kylehagin/AM3358_Schematic/README.md

# AM3358_Schematic
AM3358 Schematic with ram, lcds, and sd card interface.
