kylehagin/AM3358_Schematic/BOM_DELTA_7_25_2016.xlsx

Sheet: BOM
Description | Designator | Value | Footprint | Manufacturer | Manufacturer Part Number | Quantity | Supplier 1 | Supplier Part Number 1
4.7µF 6.3V Ceramic Capacitor X5R 0402 (1005 Metric) 0.039" L x 0.020" W (1.00mm x 0.50mm) | C1, C2, C6, C7, C100, C121, C139, C152 | 4.7uF, 6.3V | 0402 | Murata Electronics North America | GRM155R60J475ME47D | 8 | Digi-Key | 490-5915-1-ND
25pF 50V Ceramic Capacitor C0G, NP0 0603 (1608 Metric) 0.063" L x 0.031" W (1.60mm x 0.80mm) | C11, C12 | 25pF,50V | 0603 | Samsung Electro-Mechanics America, Inc. | CL10C250JB8NNNC | 2 | Digi-Key | 1276-2244-1-ND
10µF 10V Ceramic Capacitor X5R 0402 (1005 Metric) 0.039" L x 0.020" W (1.00mm x 0.50mm) | C3, C4, C5, C8, C9, C10, C14, C15, C17, C18, C19, C21, C22, C135, C159, C165, C179, C180, C193, C220 | 10uF, 10V | 0402 | Samsung Electro-Mechanics America, Inc. (http://www.digikey.com/en/supplier-centers/s/samsung-electro-mechanics-america) | CL05A106MP8NUB8 | 20 | Digi-Key | 1276-6830-1-ND
18pF 50V Ceramic Capacitor C0G, NP0 0402 (1005 Metric) 0.039" L x 0.020" W (1.00mm x 0.50mm) | C13, C137, C144, C163 | 18pF, 50V | 0402 | Murata Electronics North America | GRM1555C1H180JA01D | 4 | Digi-Key | 490-5858-1-ND
22µF 6.3V Ceramic Capacitor X5R 0402 (1005 Metric) 0.039" L x 0.020" W (1.00mm x 0.50mm) | C16, C116 | 22uF, 6.3V | 0402 | AVX Corporation | 04026D226MAT2A | 2 | Digi-Key | 478-9839-1-ND
2.2µF 6.3V Ceramic Capacitor X5R 0402 (1005 Metric) 0.039" L x 0.020" W (1.00mm x 0.50mm) | C20, C47, C48, C49, C50, C51, C52, C53, C54 | 2.2uF, 6.3V | 0402 | Murata Electronics North America | GRM155R60J225KE95D | 9 | Digi-Key | 490-12532-1-ND
4.7pF 10V Ceramic Capacitor C0G, NP0 0402 (1005 Metric) 0.039" L x 0.020" W (1.00mm x 0.50mm) | C31, C32, C33, C34, C35, C36, C37, C38, C39, C40, C41, C42, C43, C44, C45, C46 | 4.7pF, 10V | 0402 | Wurth Elektronik | 885012005005 | 16 | Digi-Key | 732-7423-1-ND
10000pF 16V Ceramic Capacitor X7R 0402 (1005 Metric) 0.039" L x 0.020" W (1.00mm x 0.50mm) | C23, C24,C25, C26, C27, C28, C29, C102, C103, C104, C105, C106, C107, C108, C109, C110, C111, C112, C113, C114, C115, C117, C118, C134, C149, C154, C157, C167, C170, C171, C172, C173, C174, C175, C176, C177, C178, C181, C182, C183, C184, C185, C186, C187, C188, C192, C194, C195, C196, C197, C198, C199, C200, C201, C202, C203, C204, C205, C206, C207, C208, C209, C210, C211, C212, C213, C214, C215, C216, C217, C218, C219, C221, C222, C223, C224, C225, C226, C227, C228, C229, C230 | 0.01uF, 16V | 0402 | Murata Electronics North America | GRM155R71C103KA01D | 82 | Digi-Key | 490-1313-1-ND
1000pF 50V Ceramic Capacitor X7R 0402 (1005 Metric) 0.039" L x 0.020" W (1.00mm x 0.50mm) | C30, C55 | 0.001uF, 50V | 0402 | Murata Electronics North America | GRM155R71H102KA01D | 2 | Digi-Key | 490-1303-1-ND
0.10µF 16V Ceramic Capacitor X7R 0402 (1005 Metric) 0.039" L x 0.020" W (1.00mm x 0.50mm) | C119, C120, C122, C123, C136, C138, C140, C141, C142, C143, C147, C148, C150, C151, C156, C158, C160, C161, C162, C164, C166, C613 | 0.1uF, 16V | 0402 | Murata Electronics North America | GRM155R71C104KA88J | 22 | Digi-Key | 490-6328-1-ND
0.10µF 6.3V Ceramic Capacitor X7R 0402 (1005 Metric) 0.039" L x 0.020" W (1.00mm x 0.50mm) | C56, C57, C58, C59, C60, C61, C62, C63, C64, C65, C66, C67, C68, C69, C70, C71, C72 | 0.1uF, 6.3V | 0402 | Kemet | C0402C104K9RACTU | 17 | Digi-Key | 399-4872-1-ND
470pF 50V Ceramic Capacitor X7R 0402 (1005 Metric) 0.039" L x 0.020" W (1.00mm x 0.50mm) | C124 | 470pF, 5%, 50V | 0402 | Murata Electronics North America | GRM155R71H471JA01D | 1 | Digi-Key | 490-6362-1-ND
1µF 10V Ceramic Capacitor X5R 0402 (1005 Metric) 0.039" L x 0.020" W (1.00mm x 0.50mm) | C125, C189, C190, C191, C231, | 1uF, 10V | 0402 | Murata Electronics North America | GRM155R61A105KE15D | 5 | Digi-Key | 490-3890-1-ND
0.022µF 10V Ceramic Capacitor X7R 0402 (1005 Metric) 0.039" L x 0.020" W (1.00mm x 0.50mm) | C130 | 0.022uF, 10V | 0402 | Taiyo Yuden | LMK105B7223KV-F | 1 | Digi-Key | 587-2476-1-ND
30pF 50V Ceramic Capacitor C0G, NP0 0402 (1005 Metric) 0.039" L x 0.020" W (1.00mm x 0.50mm) | C131, C132 | 30pF, 50V | 0402 | Murata Electronics North America | GRM1555C1H300JA01D | 2 | Digi-Key | 490-5935-1-ND
100µF 6.3V Aluminum Capacitors Radial, Can - SMD 2000 Hrs @ 85°C | C133 | 100uF, 6.3V | Radial, SMD Series S Type V | Panasonic Electronic Components | EEE-0JA101WR | 1 | Digi-Key | PCE3853CT-ND
27pF 50V Ceramic Capacitor C0G, NP0 0402 (1005 Metric) 0.039" L x 0.020" W (1.00mm x 0.50mm) | C153, C155 | 27pF, 50V | 0805 | Samsung Electro-Mechanics America, Inc. | CL05C270JB5NNNC | 2 | Digi-Key | 1276-1153-1-ND
LED GREEN CLEAR 0805 SMD | D1 |  |  | Dialight | 5988170107F | 1 | Digi-Key | 350-2044-1-ND
Low Current LED | D2, D3, D4, D5 | InGaAlP LED | PLCC-2 package | TOPLED | LG T67K-H2K1-24-Z | 4 | Digi-Key | 475-2679-1-ND
ESD protection for ultra high-speed interfaces | D6, D7 | TVS ARRAY | DFN2510A-10 (SOT1176-1) | NXP | IP4283CZ10-TBR | 2 | Digi-Key | 568-10487-1-ND
Schottky barrier single diodes | D8 | Schottky diodes | SOD323 (SC-76) | NXP | RB751V40,115 | 1 | Digi-Key | 568-8119-1-ND
FIXED IND 1.5NH 800MA 150 MOHM | FB1, FB4, FB5, FB6, FB7, FB8, FB9 , FB10 | 150OHM 800mA | 0603 | Toko America Inc. | PTL1608-F1N5C | 8 | Digi-Key | TKS2902CT-ND
FIXED IND 2.2UH 2.6A 115 MOHM | L1, L2, L3, L4 | 2.2uH,2.6A | 1008 (2520 Metric) | Murata Electronics North America | DFE252010P-2R2M=P2 | 4 | Digi-Key | 490-10637-1-ND
HDMI Type D Receptacle | P1 |  |  | FCI | 10118242-001RLF | 1 | Digikey | 609-4617-1-ND
USB - mini A Receptacle Connector 5 Position Surface Mount | P2 | USB - mini A |  | TE Connectivity | 1734327-1 | 1 | Digikey | A123107-ND
USB - mini A Receptacle Connector 5 Position Surface Mount | P3 | USB - mini B |  | HIROSE | UX60-MB-5ST | 1 | Digikey | H2959CT-ND
Micro SD Card Socket | P4 | microSD |  | Molex | 0492250821 | 1 | Digikey | WM3295CT-ND
DC POWER JACK - RIGHT ANGLED - THT - 2.0 & 2.5Ø -WR-DC | P5 | DC POWER JACK | THT - 2.0 & 2.5Ø -WR-DC | Wurth Elektronik | 694106301002 | 1 | Digikey | 732-5930-ND
.100” [2.54 mm] Contact Centers, Female Headers | P6 | 2x5 Female Headers | .100” [2.54 mm] | Sullins | PPTC052LFBN-RC | 1 | Digikey | S6105-ND
10 Position Receptacle Connector 0.079" (2.00mm) Surface Mount Gold | P7 | 10 Position Receptacle Connector | 0.079" (2.00mm) Surface Mount | Molex | 0791091004 | 1 | Digikey | WM18700-ND
.100” [2.54 mm] Contact Centers, Female Headers | P8, P9 | 2 x23 Female Headers | .100” [2.54 mm] | Sullins | PPPC232LFBN-RC | 2 | Digikey | S7126-ND
WE-RJ45-LAN-10/100BT | P10 | ;'RJ45-LAN-10/100BT |  | Wurth Elektronik | 7499010211A | 1 | Digikey | 732-4506-5-ND
Sitara™ ARM® Cortex®-A8 32‑Bit RISC Processor | IC1 |  | NFBGA (324) | Texas Instrument | AM3358BZCZ100 | 1 | Digikey | 296-35869-5-ND
250-mA LDO REGULATORS | IC2 |  | 8-VSSOP | Texas Instrument | TPS77301DGK | 1 | Digikey | 296-8108-5-ND
Positive Overvoltage Protection Controller with Internal Low RON NMOS FET | U1 |  | DFN6 | ON Semiconductor | NCP349MNBKTBG | 1 | Digikey | NCP349MNBKTBGOSCT-ND
Single-Chip PMIC for Battery-Powered Systems | U2 | 2-A Output Current | VQFN (48) | Texas Instrument | TPS65217BRSLR | 1 | Digikey | 296-40879-1-ND
1K Microwire Compatible Serial EEPROM | U3 | 1Kbit | SOT-23-6 | Microchip | 93C46BT-I/OT | 1 | Digikey | 93C46BT-IOTCT-ND
Low power, 150 MHz pixel rate HDMI 1.4a transmitter with 3 x 8-bit video inputs, HDCP and CEC support | U5 | 150 MHz pixel rate | SOT804-4 | NXP | TDA19988BHN C1,557 | 1 | Digikey | 568-12059-ND
DDR2 SDRAM | U6 | 16 Meg x 16 x 8 banks | 90-FBGA | Micron | MT47H128M16RT-25EC | 1 | Digikey | 557-1535-ND
256 kb I2C CMOS Serial EEPROM | U7 | 256 kb | SOIC8 | ON Semiconductor | CAT24C256WI-GT3 | 1 | Digikey | CAT24C256WI-GT3OSCT-ND
4Gb DDR3L, IC SDRAM DDR3 256M X 16 | U8 | 4Gb | 96-FBGA | Alliance Memory | AS4C256M16D3L-12BCN | 1 | Digikey | 1450-1097-ND
IC 0.5A Power-Distribution Switches | U9 | 500-Ma | DGN | Texas Instrument | TPS2051BDGNR | 1 | Digikey | 296-17313-1-ND
4-Channel ESD Solution for USB-HS/USB OTG/USB Charger Interface | U10 |  | DRY(R-PUSON-N6) | Texas Instrument | TPD4S012DRYR | 1 | Digikey | 296-24244-1-ND
2-Port USB 2.0 Hi-Speed Hub Controller | U11 |  | QFN28 | SMSC | USB2412-DZK-TR | 1 | Digikey | USB2412-DZK-CT-ND
Dual High Speed USB to Multipurpose UART/FIFO IC | U12 |  | QFN64-HQ | FTDI | FT2232HQ-REEL | 1 | Digikey | 768-1025-1-ND
Small Footprint MII/RMII 10/100 Ethernet Transceiver with HP Auto-MDIX and flexPWR® Technology | U13 | 10/100 Ethernet Transceiver | 32-QFN | SMSC | LAN8710A-EZC-TR | 1 | Digikey | LAN8710A-EZC-CT-ND
Dual 2-Input Positive-NAND Gate | U14 | NAND Gate | DCK(R-PDSO-G6) | Texas Instrument | SN74LVC2G00DCUR | 1 | Digikey | 296-13258-1-ND
Small Footprint MII/RMII 10/100 Ethernet Transceiver with HP Auto-MDIX and flexPWR® Technology | U15 | 10/100 Ethernet Transceiver | 32-QFN | SMSC | LAN8710A-EZC-TR | 1 | Digikey | LAN8710A-EZC-CT-ND
SN74LVC2G07 Dual Buffer and Driver With Open-Drain Outputs | U16 | 24-mA Output Drive at 3.3 V | DCK(R-PDSO-G6) | Texas Instrument | SN74LVC2G07DCKR | 1 | Digikey | 296-13495-1-ND
Silicon NPN epitaxial planar type | Q1, Q2 | Silicon NPN | SOT-363 | Panasonic | DMC564040R | 1 | Digikey | DMC564040RCT-ND
TRANS NPN PREBIAS/PNP SSMINI6 | Q3 | 1 NPN Pre-Biased, 1 PNP | SOT-364 | Panasonic | DME914C10R | 1 | Digikey | DME914C10RCT-ND
RES SMD 4.75K OHM 1% 1/16W 0402 | R1, R152, R162, R176, R179 | 4.75K, 1% | 0402 | Yageo | RC0402FR-074K75L | 5 | Digikey | 311-4.75KLCT-ND
RES SMD 12.1K OHM 1% 1/16W 0402 | R2, R145, R157, R167, R282 | 12.1K, 1% | 0402 | Yageo | RC0402FR-0712K1L | 5 | Digikey | 311-12.1KLRCT-ND
RES SMD 0.1 OHM 1% 1/10W 0402 | R3, R138 | 0.1 | 0402 | Samsung Electro-Mechanics America, Inc. | RUT1005FR100CS | 2 | Digikey | 1276-6167-1-ND
RES SMD 1.5K OHM 5% 1/16W 0402 | R4, R7, R20, R21, R30, R131 | 1.5K, 5% | 0402 | Yageo | RC0402JR-071K5L | 3 | Digikey | 311-1.5KJRCT-ND
RES SMD 470 OHM 5% 1/16W 0402 | R6, R16, R96, R97, R98, R99 | 470, 5% | 0402 | Yageo | RC0402JR-07470RL | 6 | Digikey | 311-470JRCT-ND
RES SMD 100K OHM 1% 1/16W 0402 | R8, R9, R81, R82, R84, R94, R116, R117, R118, R119, R132, R151, R156, R159, | 100K, 1% | 0402 | Yageo | RC0402FR-07100KL | 14 | Digikey | 311-100KLRCT-ND
RES SMD 100 OHM 1% 1/16W 0402 | R135, R136, R137, R139, R153, R205, R206, R207, R208, R279 | 100, 1% | 0402 | Yageo | RC0402FR-07100RL | 10 | Digikey | 311-100LRCT-ND
RES SMD 0.0OHM JUMPER 1/16W 0402 | R11, R12, R13, R14, R15, R19, R28, R78, R120, R121, R142, R146, R161, R163, R164, R165, R166, R168, R169, R170, R171, R172, R197, R199, R202, R204, R217, R222, R224, R275, R277, R278 | 0 | 0402 | Yageo | RC0402JR-070RL | 32 | Digikey | 311-0.0JRCT-ND
RES SMD 42.2K OHM 1% 1/16W 0402 | R103, R105, R106, R107, R108, R109, R110, R111, R112, R113, R115 | 42.2K, 1% | 0402 | Yageo | RC0402FR-0742K2L | 11 | Digikey | 311-42.2KLRCT-ND
RES SMD 10K OHM 1% 1/16W 0402 | R18, R24, R26, R27, R29, R31, R32, R33, R34, R123, R124, R125, R147, R148, R174, R187, R190, R191, R192, R193, R194, R195, R196, R210, R212, R214, R216, R219, R220, R276, R283 | 10K, 1% | 0402 | Yageo | RC0402FR-0710KL | 26 | Digikey | 311-10.0KLRCT-ND
RES SMD 10 OHM 1% 1/16W 0402 | R144 | 10, 1% | 0402 | Yageo | RC0402FR-0710RL | 1 | Digikey | 311-10.0LRCT-ND
RES SMD 49.9 OHM 1% 1/16W 0402 | R129, R130, R133, R134, R229 | 49.9, 1% | 0402 | Yageo | RC0402FR-0749R9L | 5 | Digikey | 311-49.9LRCT-ND
RES SMD 52.3K OHM 1% 1/16W 0402 | R150 | 52.3K, 1% | 0402 | Yageo | RC0402FR-0752K3L | 1 | Digikey | YAG3179CT-ND
RES SMD 2.2K OHM 1% 1/16W 0402 | R175, R188, R226, R232 | 2.2K, 1% | 0402 | Yageo | RC0402FR-072K2L | 4 | Digikey | 311-2.20KLRCT-ND
RES SMD 30.1K OHM 1% 1/16W 0402 | R189 | 30.1K, 1% | 0402 | Yageo | RC0402FR-0730K1L | 1 | Digikey | 311-30.1KLRCT-ND
RES SMD 33 OHM 5% 1/16W 0402 | R201, R225, R227, R228, R229, R230, R231, R232, R233, R234, R235, R236, R237, R238, R239, R240, R241, R242, R243, R244, R245, R246, R247, R248, R249, R250, R251, R252, R253, R254, R255, R256, R257, R258, R259,R260, R261, R262, R263, R264, R265, R266, R267, R268, R269, R270, R271, R272, R273, R274 | 33 | 0402 | Yageo | RC0402JR-0733RL | 50 | Digikey | 311-33JRCT-ND
RES SMD 1M OHM 1% 1/16W 0402 | R223 | 1M, 1% | 0402 | Yageo | RC0402FR-071ML | 1 | Digikey | 311-1.00MLRCT-ND
RES SMD 27K OHM 1% 1/10W 0402 | R23, R27 | 27K, 1% | 0402 | Panasonic Electronic Components | ERJ-2RKF2702X | 2 | Digikey | P27.0KLCT-ND
RES SMD 240 OHM 1% 1/16W 0402 | R25 | 240 | 0402 | Yageo | C0402FR-07240RL | 1 | Digikey | 311-240LRCT-ND
RES SMD 7.5 OHM 1% 1/16W 0402 | R35 | 7.5 OHM | 0402 | Samsung Electro-Mechanics America, Inc. | RC1005F7R5CS | 1 | Digikey | 1276-3880-1-ND
Overcurrent Protection Device | RT1 | 60V MAX, 40A MAX | Through hole | TE Connectivity | RXEF010 | 1 | Digikey | RXEF010HF-ND
Ultra-small Tactile Switch (SMT) | S1 | SPST-NO | (1.2 × 3 × 2.5 mm (H × W × D) | Omron | B3U-1100P | 1 | Digikey | SW1021CT-ND
ATS/ATS-SM Series Quartz Crystal | Y4 | 25MHz | HC-49/US-SM [surface mount] | CTS Electronic Components | ATS250B-E | 1 | Digikey | CTX928-ND
12MHz ±50ppm Crystal 8pF 80 Ohm -10°C ~ 70°C Surface Mount 2-SMD, No Lead (DFN, LCC) | Y6 | 12MHz | 2-SMD, No Lead (DFN, LCC) | NDK | NX8045GB-12.000000MHZ | 1 | Digikey | 644-1020-1-ND
kHz RANGE CRYSTAL UNIT | Y7 | 32.768 kHz | 8.0 × 3.8 × 2.54 mm | Seiko Epson Corp | MC-306 32.7680K-A0 | 1 | Digikey | SER2407CT-ND
Surface Mount Quartz Crystal | Y8, Y5 | 24MHz | 5.0mm x 3.2mm | CTS Electronic Components | 405I35D24M00000 | 1 | Digikey | CTX1198CT-ND

Sheet: Sheet1
0.21653999 | -0.60803002
4.15353999 | -0.60803002
0.39525997 | -2.26156004
3.97525997 | -2.26156004
 | 0.06299003
 | 0.05512008
