kylehagin/AM3358_Schematic/DELTA_7_25_2016.brd

## EAGLE design DELTA_7_25_2016.brd (2018-07-20)

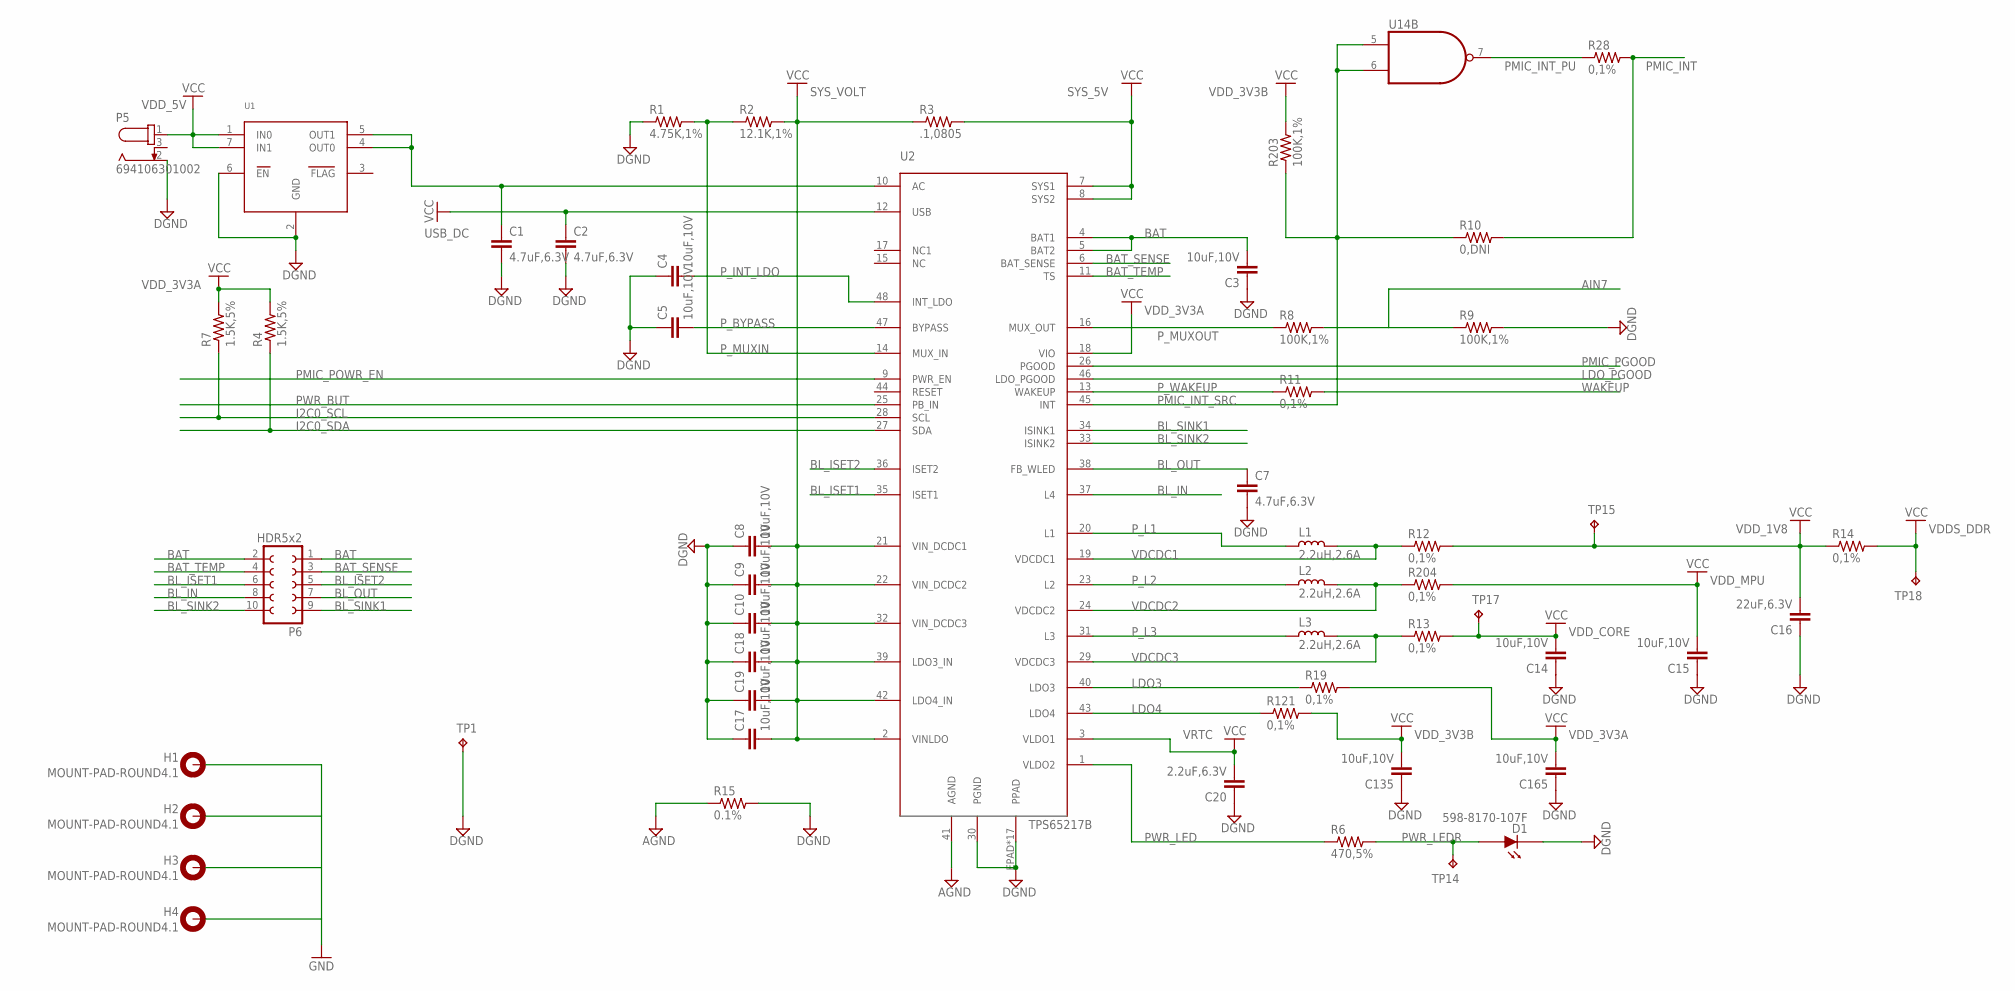
[picture p1: schematic DELTA_7_25_2016.sch, sheet 1]

Parts:
C1, C2, C7: 4.7uF,6.3V; C0402
C3, C4, C5, C8, C9, C10, C14, C15, C17, C18, C19, C135, C165: 10uF,10V; C0402
C16: 22uF,6.3V; C0402
C20: 2.2uF,6.3V; C0402
D1: 598-8170-107F; 0805P
H1, H2, H3, H4: MOUNT-PAD-ROUND4.1; 4,1-PAD
L1, L2, L3: 2.2uH,2.6A; L1008
P5: 694106301002
P6: HDR5x2; FE05-2
R1: 4.75K,1%; R0402
R2: 12.1K,1%; R0402
R3: .1,0805; R0402
R4, R7: 1.5K,5%; R0402
R6: 470,5%; R0402
R8, R9, R203: 100K,1%; R0402
R10: 0,DNI; R0402
R11, R12, R13, R14, R19, R28, R121, R204: 0,1%; R0402
R15: 0.1%; R0402
TP1, TP14, TP15, TP17, TP18: TPB1,27; B1,27
U1: NCP349; DFN6
U2: TPS65217B; RSL(S-PVQFN-N48)
U14: SN74LVC2G00DCU; DCU(S-PDSO-G8)

Connections:
AGND: R15.1, U2.41 (AGND)
AIN7: R8.2, R9.1; also elsewhere on the board
BAT: C3.2, P6.1, P6.2, U2.4 (BAT1), U2.5 (BAT2)
BAT_SENSE: P6.3, U2.6 (BAT_SENSE)
BAT_TEMP: P6.4, U2.11 (TS)
BL_IN: P6.8, U2.37 (L4)
BL_ISET1: P6.6, U2.35 (ISET1)
BL_ISET2: P6.5, U2.36 (ISET2)
BL_OUT: C7.1, P6.7, U2.38 (FB_WLED)
BL_SINK1: P6.9, U2.34 (ISINK1)
BL_SINK2: P6.10, U2.33 (ISINK2)
DGND: C1.2, C2.2, C3.1, C4.1, C5.1, C7.2, C8.1, C9.1, C10.1, C14.1, C15.1, C16.1, C17.1, C18.1, C19.1, C20.1, C135.1, C165.1, D1.2 (D_OUT), P5.2, R1.1, R9.2, R15.2, TP1.TP, U1.2 (GND), U1.6 (EN), U2.30 (PGND), U2.EPAD (PPAD), U2.P$1 (PPAD), U2.P$2 (PPAD), U2.P$3 (PPAD), U2.P$4 (PPAD), U2.P$5 (PPAD), U2.P$6 (PPAD), U2.P$7 (PPAD), U2.P$8 (PPAD), U2.P$9 (PPAD), U2.P$10 (PPAD), U2.P$11 (PPAD), U2.P$12 (PPAD), U2.P$13 (PPAD), U2.P$14 (PPAD), U2.P$15 (PPAD), U2.P$16 (PPAD); also elsewhere on the board
GND: H1.B4,1, H2.B4,1, H3.B4,1, H4.B4,1; also elsewhere on the board
I2C0_SCL: R7.1, U2.28 (SCL); also elsewhere on the board
I2C0_SDA: R4.1, U2.27 (SDA); also elsewhere on the board
LDO3: R19.1, U2.40 (LDO3)
LDO4: R121.1, U2.43 (LDO4)
LDO_PGOOD: U2.46 (LDO_PGOOD); also elsewhere on the board
unnamed: C1.1, U1.4 (OUT0), U1.5 (OUT1), U2.10 (AC)
PMIC_INT: R10.2, R28.2; also elsewhere on the board
PMIC_INT_PU: R28.1, U14.7 (O)
PMIC_INT_SRC: R10.1, R203.1, U2.45 (INT), U14.5 (I0), U14.6 (I1)
PMIC_PGOOD: U2.26 (PGOOD); also elsewhere on the board
PMIC_POWR_EN: U2.9 (PWR_EN); also elsewhere on the board
PWR_BUT: U2.25 (PB_IN); also elsewhere on the board
PWR_LED: R6.1, U2.1 (VLDO2)
PWR_LEDR: D1.1 (D_IN), R6.2, TP14.TP
P_BYPASS: C5.2, U2.47 (BYPASS)
P_INT_LDO: C4.2, U2.48 (INT_LDO)
P_L1: L1.2, U2.20 (L1)
P_L2: L2.2, U2.23 (L2)
P_L3: L3.2, U2.31 (L3)
P_MUXIN: R1.2, R2.1, U2.14 (MUX_IN)
P_MUXOUT: R8.1, U2.16 (MUX_OUT)
P_WAKEUP: R11.1, U2.13 (WAKEUP)
SYS_5V: R3.2, U2.7 (SYS1), U2.8 (SYS2); also elsewhere on the board
SYS_VOLT: C8.2, C9.2, C10.2, C17.2, C18.2, C19.2, R2.2, R3.1, U2.2 (VINLDO), U2.21 (VIN_DCDC1), U2.22 (VIN_DCDC2), U2.32 (VIN_DCDC3), U2.39 (LDO3_IN), U2.42 (LDO4_IN); also elsewhere on the board
USB_DC: C2.1, U2.12 (USB); also elsewhere on the board
VDCDC1: L1.1, R12.1, U2.19 (VDCDC1)
VDCDC2: L2.1, R204.1, U2.24 (VDCDC2)
VDCDC3: L3.1, R13.1, U2.29 (VDCDC3)
VDDS_DDR: R14.2, TP18.TP; also elsewhere on the board
VDD_1V8: C16.2, R12.2, R14.1, TP15.TP; also elsewhere on the board
VDD_3V3A: C165.2, R4.2, R7.2, R19.2, U2.18 (VIO); also elsewhere on the board
VDD_3V3B: C135.2, R121.2, R203.2; also elsewhere on the board
VDD_5V: P5.1, U1.1 (IN0), U1.7 (IN1); also elsewhere on the board
VDD_CORE: C14.2, R13.2, TP17.TP; also elsewhere on the board
VDD_MPU: C15.2, R204.2; also elsewhere on the board
VRTC: C20.2, U2.3 (VLDO1); also elsewhere on the board
WAKEUP: R11.2; also elsewhere on the board

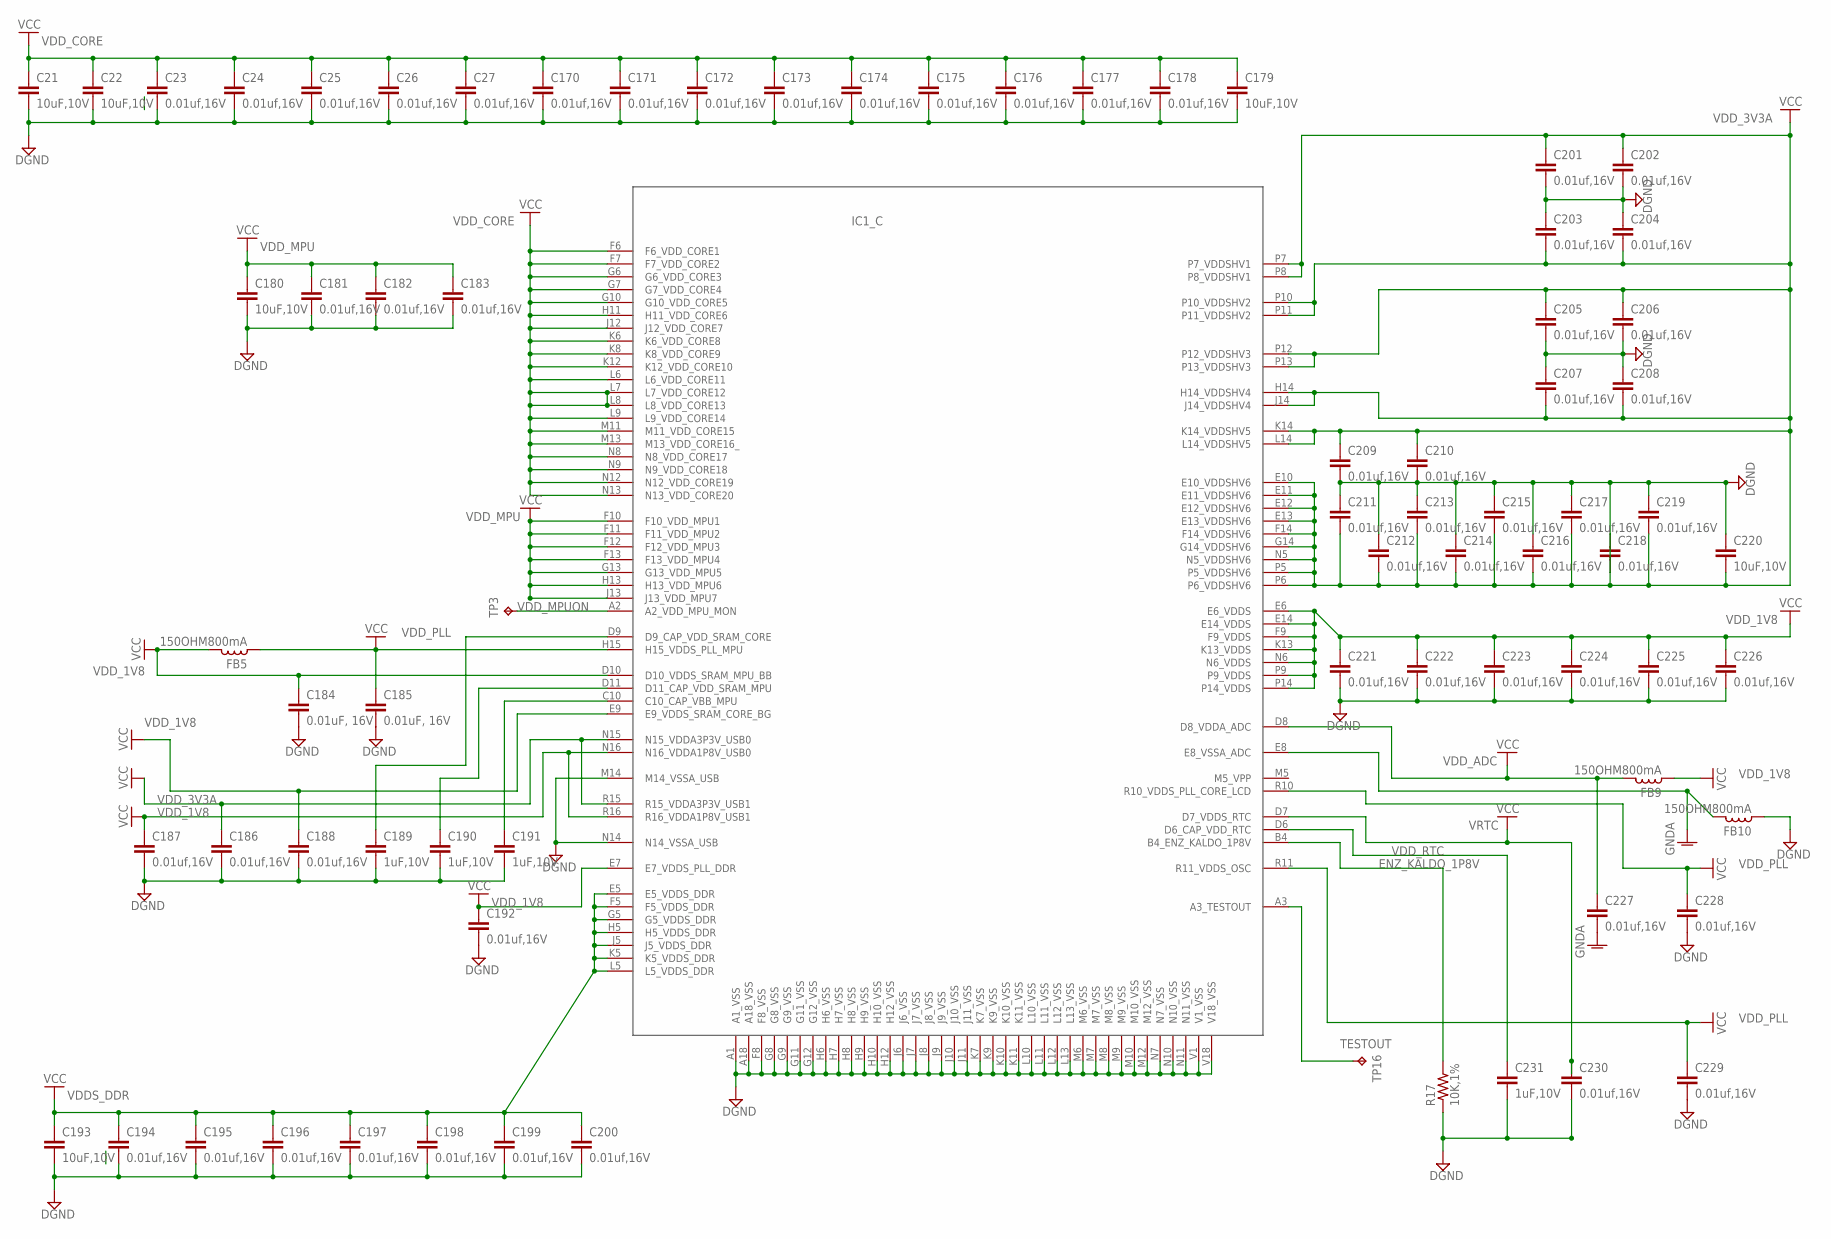
[picture p2: schematic DELTA_7_25_2016.sch, sheet 2]

Parts:
C21, C22, C179, C180, C193, C220: 10uF,10V; C0402
C23, C24, C25, C26, C27, C170, C171, C172, C173, C174, C175, C176, C177, C178, C181, C182, C183, C186, C187, C188, C192, C194, C195, C196, C197, C198, C199, C200, C201, C202, C203, C204, C205, C206, C207, C208, C209, C210, C211, C212, C213, C214, C215, C216, C217, C218, C219, C221, C222, C223, C224, C225, C226, C227, C228, C229, C230: 0.01uf,16V; C0402
C184, C185: 0.01uF, 16V; C0402
C189, C190, C191, C231: 1uF,10V; C0402
FB5, FB9: 150OHM800mA; L0603
FB10: 150OHM800mA; L1812
IC1: AM335X_ZCZ; ZCZ_S-PBGA-N324
R17: 10K,1%; R0402
TP3, TP16: TPB1,27; B1,27

Connections:
DGND: C21.2, C22.2, C23.2, C24.2, C25.2, C26.2, C27.2, C170.2, C171.2, C172.2, C173.2, C174.2, C175.2, C176.2, C177.2, C178.2, C179.2, C180.2, C181.2, C182.2, C183.2, C184.2, C185.2, C186.2, C187.2, C188.2, C189.2, C190.2, C191.2, C192.2, C193.2, C194.2, C195.2, C196.2, C197.2, C198.2, C199.2, C200.2, C201.2, C202.2, C203.1, C204.1, C205.2, C206.2, C207.1, C208.1, C221.2, C222.2, C223.2, C224.2, C225.2, C226.2, C228.2, C229.2, C230.2, C231.2, FB10.2, IC1.A1 (A1_VSS), IC1.A18 (A18_VSS), IC1.F8 (F8_VSS), IC1.G8 (G8_VSS), IC1.G9 (G9_VSS), IC1.G11 (G11_VSS), IC1.G12 (G12_VSS), IC1.H6 (H6_VSS), IC1.H7 (H7_VSS), IC1.H8 (H8_VSS), IC1.H9 (H9_VSS), IC1.H10 (H10_VSS), IC1.H12 (H12_VSS), IC1.J6 (J6_VSS), IC1.J7 (J7_VSS), IC1.J8 (J8_VSS), IC1.J9 (J9_VSS), IC1.J10 (J10_VSS), IC1.J11 (J11_VSS), IC1.K7 (K7_VSS), IC1.K9 (K9_VSS), IC1.K10 (K10_VSS), IC1.K11 (K11_VSS), IC1.L10 (L10_VSS), IC1.L11 (L11_VSS), IC1.L12 (L12_VSS), IC1.L13 (L13_VSS), IC1.M6 (M6_VSS), IC1.M7 (M7_VSS), IC1.M8 (M8_VSS), IC1.M9 (M9_VSS), IC1.M10 (M10_VSS), IC1.M12 (M12_VSS), IC1.M14 (M14_VSSA_USB), IC1.N7 (N7_VSS), IC1.N10 (N10_VSS), IC1.N11 (N11_VSS), IC1.N14 (N14_VSSA_USB), IC1.V1 (V1_VSS), IC1.V18 (V18_VSS), R17.1; also elsewhere on the board
ENZ_KALDO_1P8V: IC1.B4 (B4_ENZ_KALDO_1P8V), R17.2
GNDA: C227.2, FB10.1, IC1.E8 (E8_VSSA_ADC); also elsewhere on the board
unnamed: C189.1, IC1.D9 (D9_CAP_VDD_SRAM_CORE)
unnamed: C190.1, IC1.D11 (D11_CAP_VDD_SRAM_MPU)
unnamed: C191.1, IC1.C10 (C10_CAP_VBB_MPU)
TESTOUT: IC1.A3 (A3_TESTOUT), TP16.TP
VDDS_DDR: C193.1, C194.1, C195.1, C196.1, C197.1, C198.1, C199.1, C200.1, IC1.E5 (E5_VDDS_DDR), IC1.F5 (F5_VDDS_DDR), IC1.G5 (G5_VDDS_DDR), IC1.H5 (H5_VDDS_DDR), IC1.J5 (J5_VDDS_DDR), IC1.K5 (K5_VDDS_DDR), IC1.L5 (L5_VDDS_DDR); also elsewhere on the board
VDD_1V8: C184.1, C187.1, C188.1, C192.1, C221.1, C222.1, C223.1, C224.1, C225.1, C226.1, FB5.1, FB9.2, IC1.D10 (D10_VDDS_SRAM_MPU_BB), IC1.E6 (E6_VDDS), IC1.E7 (E7_VDDS_PLL_DDR), IC1.E9 (E9_VDDS_SRAM_CORE_BG), IC1.E14 (E14_VDDS), IC1.F9 (F9_VDDS), IC1.K13 (K13_VDDS), IC1.N6 (N6_VDDS), IC1.N16 (N16_VDDA1P8V_USB0), IC1.P9 (P9_VDDS), IC1.P14 (P14_VDDS), IC1.R16 (R16_VDDA1P8V_USB1); also elsewhere on the board
VDD_3V3A: C186.1, C201.1, C202.1, C203.2, C204.2, C205.1, C206.1, C207.2, C208.2, C209.1, C209.2, C210.1, C210.2, C211.1, C211.2, C212.1, C212.2, C213.1, C213.2, C214.1, C214.2, C215.1, C215.2, C216.1, C216.2, C217.1, C217.2, C218.1, C218.2, C219.1, C219.2, C220.1, C220.2, IC1.E10 (E10_VDDSHV6), IC1.E11 (E11_VDDSHV6), IC1.E12 (E12_VDDSHV6), IC1.E13 (E13_VDDSHV6), IC1.F14 (F14_VDDSHV6), IC1.G14 (G14_VDDSHV6), IC1.H14 (H14_VDDSHV4), IC1.J14 (J14_VDDSHV4), IC1.K14 (K14_VDDSHV5), IC1.L14 (L14_VDDSHV5), IC1.N5 (N5_VDDSHV6), IC1.N15 (N15_VDDA3P3V_USB0), IC1.P5 (P5_VDDSHV6), IC1.P6 (P6_VDDSHV6), IC1.P7 (P7_VDDSHV1), IC1.P8 (P8_VDDSHV1), IC1.P10 (P10_VDDSHV2), IC1.P11 (P11_VDDSHV2), IC1.P12 (P12_VDDSHV3), IC1.P13 (P13_VDDSHV3), IC1.R15 (R15_VDDA3P3V_USB1); also elsewhere on the board
VDD_ADC: C227.1, FB9.1, IC1.D8 (D8_VDDA_ADC); also elsewhere on the board
VDD_CORE: C21.1, C22.1, C23.1, C24.1, C25.1, C26.1, C27.1, C170.1, C171.1, C172.1, C173.1, C174.1, C175.1, C176.1, C177.1, C178.1, C179.1, IC1.F6 (F6_VDD_CORE1), IC1.F7 (F7_VDD_CORE2), IC1.G6 (G6_VDD_CORE3), IC1.G7 (G7_VDD_CORE4), IC1.G10 (G10_VDD_CORE5), IC1.H11 (H11_VDD_CORE6), IC1.J12 (J12_VDD_CORE7), IC1.K6 (K6_VDD_CORE8), IC1.K8 (K8_VDD_CORE9), IC1.K12 (K12_VDD_CORE10), IC1.L6 (L6_VDD_CORE11), IC1.L7 (L7_VDD_CORE12), IC1.L8 (L8_VDD_CORE13), IC1.L9 (L9_VDD_CORE14), IC1.M11 (M11_VDD_CORE15), IC1.M13 (M13_VDD_CORE16_), IC1.N8 (N8_VDD_CORE17), IC1.N9 (N9_VDD_CORE18), IC1.N12 (N12_VDD_CORE19), IC1.N13 (N13_VDD_CORE20); also elsewhere on the board
VDD_MPU: C180.1, C181.1, C182.1, C183.1, IC1.F10 (F10_VDD_MPU1), IC1.F11 (F11_VDD_MPU2), IC1.F12 (F12_VDD_MPU3), IC1.F13 (F13_VDD_MPU4), IC1.G13 (G13_VDD_MPU5), IC1.H13 (H13_VDD_MPU6), IC1.J13 (J13_VDD_MPU7); also elsewhere on the board
VDD_MPUON: IC1.A2 (A2_VDD_MPU_MON), TP3.TP
VDD_PLL: C185.1, C228.1, C229.1, FB5.2, IC1.H15 (H15_VDDS_PLL_MPU), IC1.R10 (R10_VDDS_PLL_CORE_LCD), IC1.R11 (R11_VDDS_OSC)
VDD_RTC: C231.1, IC1.D6 (D6_CAP_VDD_RTC)
VRTC: C230.1, IC1.D7 (D7_VDDS_RTC); also elsewhere on the board

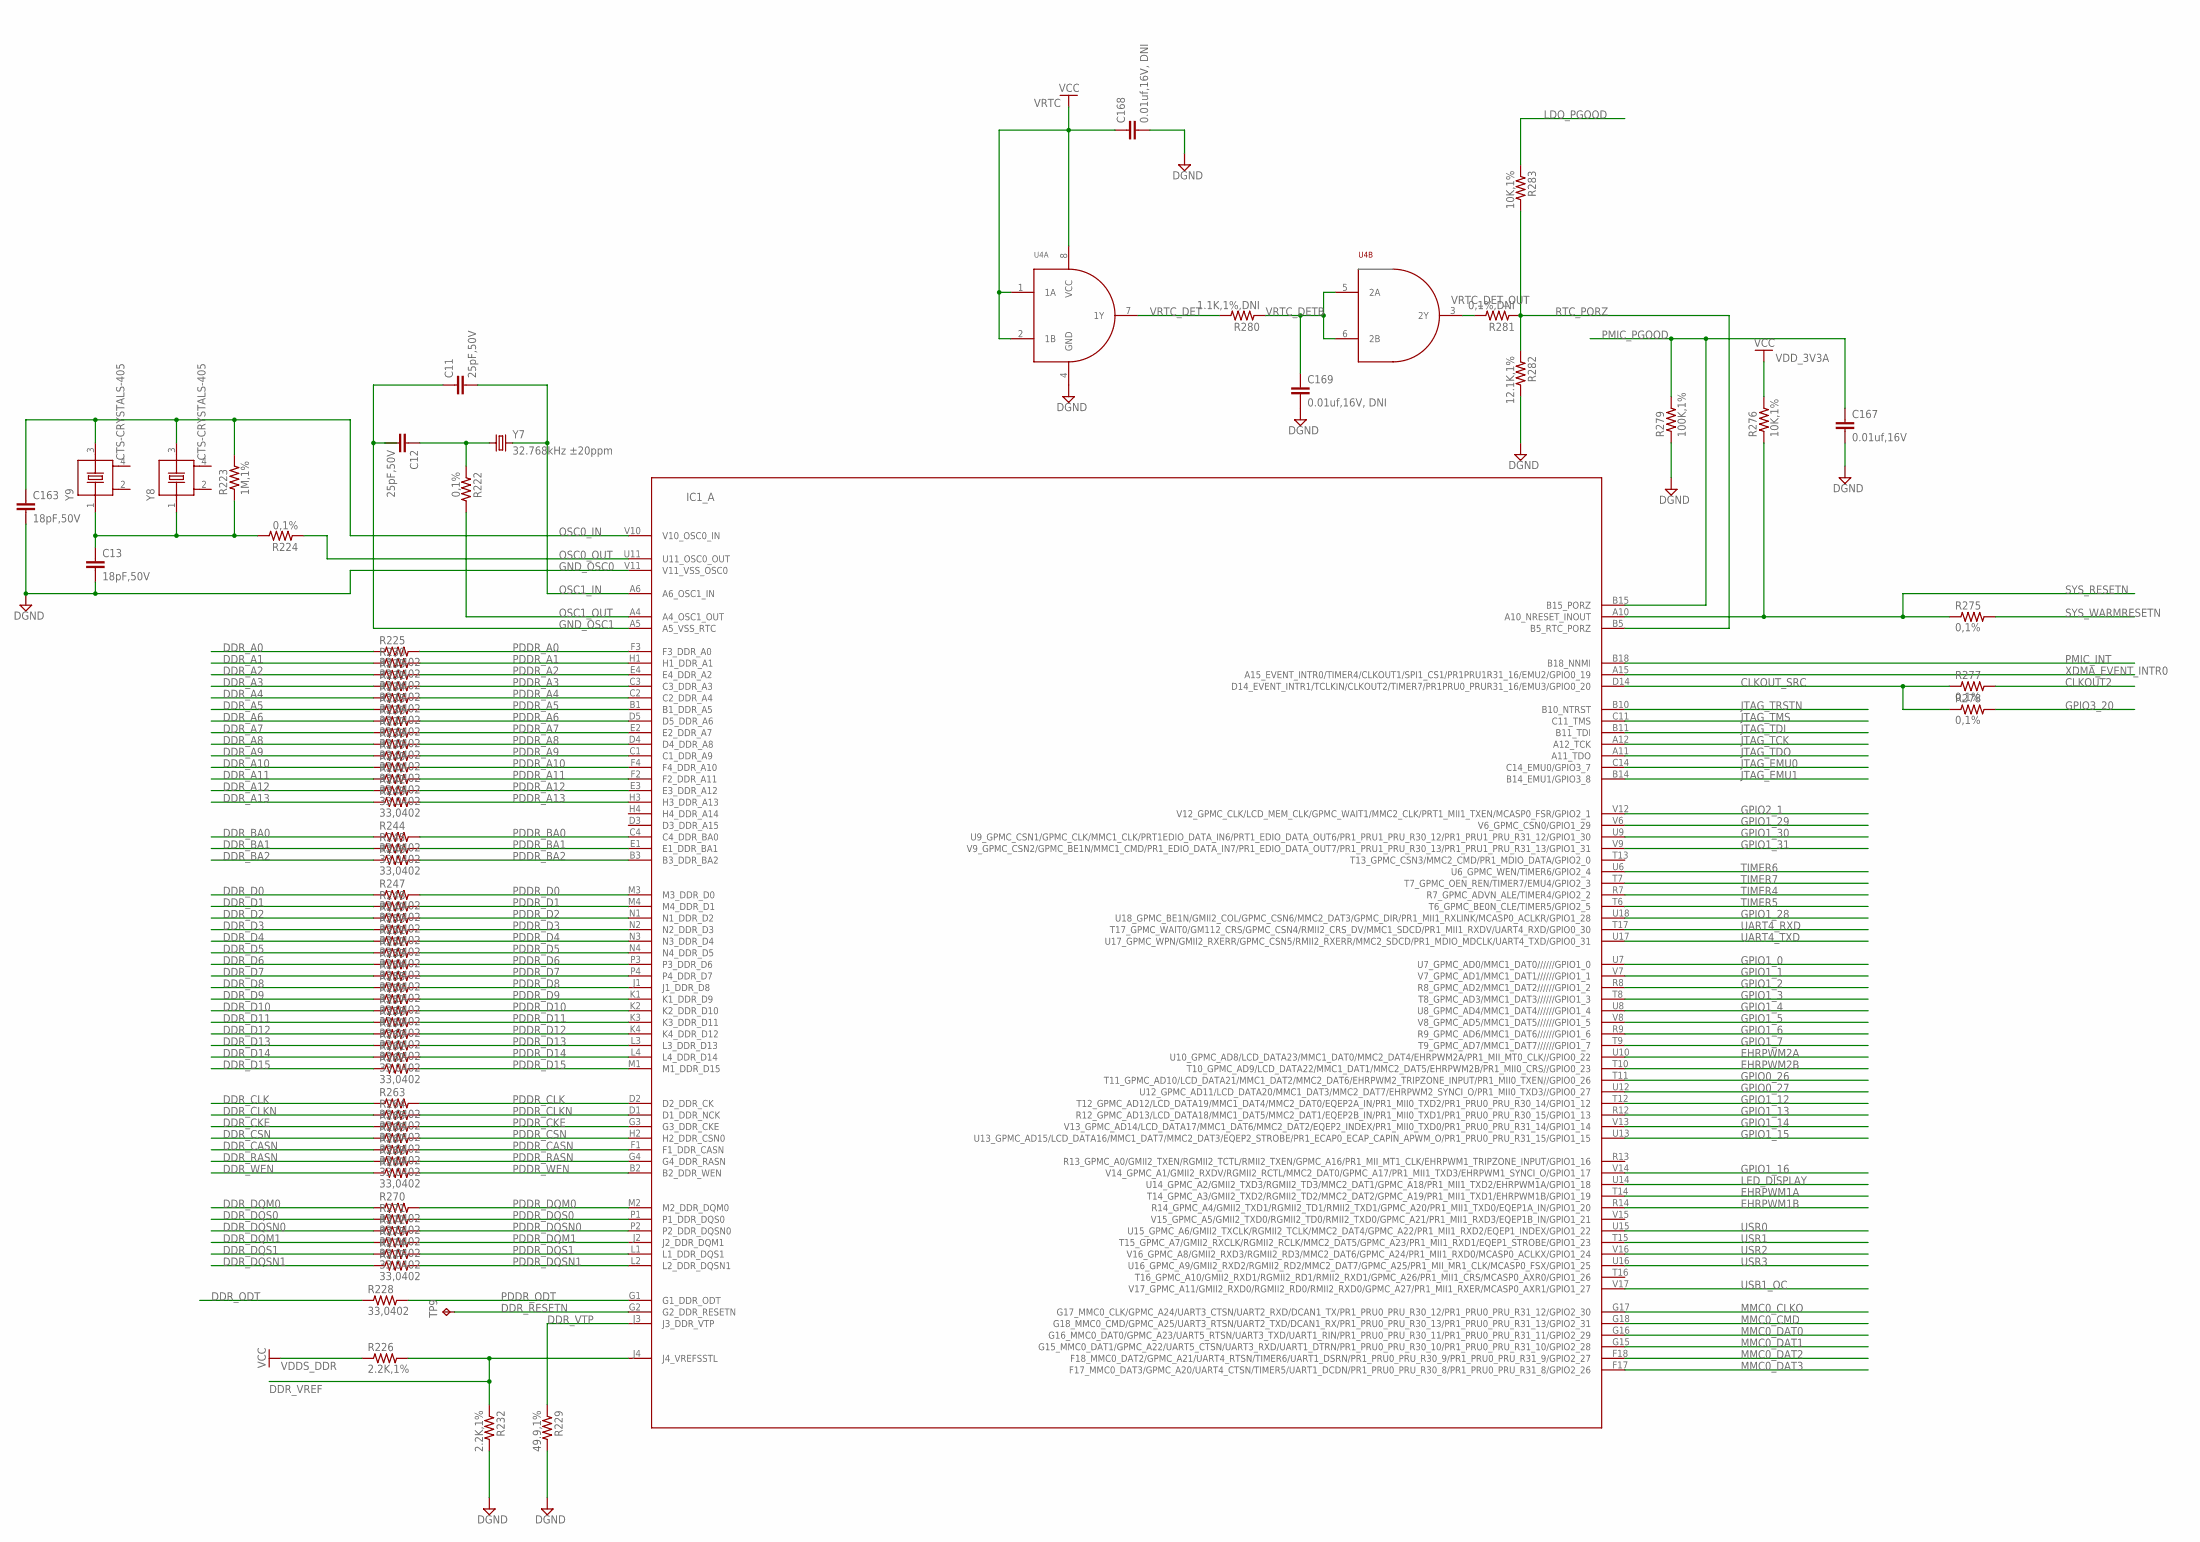
[picture p3: schematic DELTA_7_25_2016.sch, sheet 3]

Parts:
C11, C12: 25pF,50V; C0603
C13, C163: 18pF,50V; C0402
C167: 0.01uf,16V; C0402
C168, C169: 0.01uf,16V, DNI; C0402
IC1: AM335X_ZCZ; ZCZ_S-PBGA-N324
R222, R224, R275, R277, R278: 0,1%; R0402
R223: 1M,1%; R0402
R225, R227, R228, R230, R231, R233, R234, R235, R236, R237, R238, R239, R240, R241, R242, R243, R244, R245, R246, R247, R248, R249, R250, R251, R252, R253, R254, R255, R256, R257, R258, R259, R260, R261, R262, R263, R264, R265, R266, R267, R268, R269, R270, R271, R272, R273, R274: 33,0402; R0402
R226, R232: 2.2K,1%; R0402
R229: 49.9,1%; R0402
R276, R283: 10K,1%; R0402
R279: 100K,1%; R0402
R280: 1.1K,1%,DNI; R0402
R281: 0,1%,DNI; R0402
R282: 12.1K,1%; R0402
TP9: TPB1,27; B1,27
U4: SN74AUP2G08,DNI; DQE(R-PX2SON-N8),DNI
Y7: 32.768kHz ±20ppm; MC-306
Y8, Y9: CTS-CRYSTALS-405; CTS-405

Connections:
CLKOUT2: R277.2; also elsewhere on the board
CLKOUT_SRC: IC1.D14 (D14_EVENT_INTR1/TCLKIN/CLKOUT2/TIMER7/P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), R277.1, R278.1
DDR_A0: R225.1; also elsewhere on the board
DDR_A1: R230.1; also elsewhere on the board
DDR_A2: R233.1; also elsewhere on the board
DDR_A3: R231.1; also elsewhere on the board
DDR_A4: R234.1; also elsewhere on the board
DDR_A5: R235.1; also elsewhere on the board
DDR_A6: R236.1; also elsewhere on the board
DDR_A7: R237.1; also elsewhere on the board
DDR_A8: R238.1; also elsewhere on the board
DDR_A9: R239.1; also elsewhere on the board
DDR_A10: R240.1; also elsewhere on the board
DDR_A11: R241.1; also elsewhere on the board
DDR_A12: R242.1; also elsewhere on the board
DDR_A13: R243.1; also elsewhere on the board
DDR_BA0: R244.1; also elsewhere on the board
DDR_BA1: R245.1; also elsewhere on the board
DDR_BA2: R246.1; also elsewhere on the board
DDR_CASN: R267.1; also elsewhere on the board
DDR_CKE: R265.1; also elsewhere on the board
DDR_CLK: R263.1; also elsewhere on the board
DDR_CLKN: R264.1; also elsewhere on the board
DDR_CSN: R266.1; also elsewhere on the board
DDR_D0: R247.1; also elsewhere on the board
DDR_D1: R248.1; also elsewhere on the board
DDR_D2: R249.1; also elsewhere on the board
DDR_D3: R250.1; also elsewhere on the board
DDR_D4: R251.1; also elsewhere on the board
DDR_D5: R252.1; also elsewhere on the board
DDR_D6: R253.1; also elsewhere on the board
DDR_D7: R254.1; also elsewhere on the board
DDR_D8: R255.1; also elsewhere on the board
DDR_D9: R256.1; also elsewhere on the board
DDR_D10: R257.1; also elsewhere on the board
DDR_D11: R258.1; also elsewhere on the board
DDR_D12: R259.1; also elsewhere on the board
DDR_D13: R260.1; also elsewhere on the board
DDR_D14: R261.1; also elsewhere on the board
DDR_D15: R262.1; also elsewhere on the board
DDR_DQM0: R270.1; also elsewhere on the board
DDR_DQM1: R273.1; also elsewhere on the board
DDR_DQS0: R271.1; also elsewhere on the board
DDR_DQS1: R274.1; also elsewhere on the board
DDR_DQSN0: R272.1; also elsewhere on the board
DDR_DQSN1: R227.1; also elsewhere on the board
DDR_ODT: R228.1; also elsewhere on the board
DDR_RASN: R268.1; also elsewhere on the board
DDR_RESETN: IC1.G2 (G2_DDR_RESETN), TP9.TP; also elsewhere on the board
DDR_VREF: IC1.J4 (J4_VREFSSTL), R226.2, R232.1; also elsewhere on the board
DDR_VTP: IC1.J3 (J3_DDR_VTP), R229.1
DDR_WEN: R269.1; also elsewhere on the board
DGND: C167.2, C168.2, C169.2, R229.2, R232.2, R279.1, R282.2, U4.4 (GND); also elsewhere on the board
EHRPWM1A: IC1.T14 (T14_GPMC_A3/GMII2_TXD2/RGMII2_TD2/MMC2_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); also elsewhere on the board
EHRPWM1B: IC1.R14 (R14_GPMC_A4/GMII2_TXD1/RGMII2_TD1/RMII2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); also elsewhere on the board
EHRPWM2A: IC1.U10 (U10_GPMC_AD8/LCD_DATA23/MMC1_DAT0/MMC2_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); also elsewhere on the board
EHRPWM2B: IC1.T10 (T10_GPMC_AD9/LCD_DATA22/MMC1_DAT1/MMC2_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); also elsewhere on the board
GND_OSC0: C13.2, C163.2, IC1.V11 (V11_VSS_OSC0)
GND_OSC1: C11.1, C12.2, IC1.A5 (A5_VSS_RTC)
GPIO0_26: IC1.T11 (T11_GPMC_AD10/LCD_DATA21/MMC1_DAT2/MMC2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); also elsewhere on the board
GPIO0_27: IC1.U12 (U12_GPMC_AD11/LCD_DATA20/MMC1_DAT3/MMC2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); also elsewhere on the board
GPIO1_0: IC1.U7 (U7_GPMC_AD0/MMC1_DAT0//////GPIO1_0); also elsewhere on the board
GPIO1_1: IC1.V7 (V7_GPMC_AD1/MMC1_DAT1//////GPIO1_1)
GPIO1_2: IC1.R8 (R8_GPMC_AD2/MMC1_DAT2//////GPIO1_2); also elsewhere on the board
GPIO1_3: IC1.T8 (T8_GPMC_AD3/MMC1_DAT3//////GPIO1_3); also elsewhere on the board
GPIO1_4: IC1.U8 (U8_GPMC_AD4/MMC1_DAT4//////GPIO1_4); also elsewhere on the board
GPIO1_5: IC1.V8 (V8_GPMC_AD5/MMC1_DAT5//////GPIO1_5); also elsewhere on the board
GPIO1_6: IC1.R9 (R9_GPMC_AD6/MMC1_DAT6//////GPIO1_6); also elsewhere on the board
GPIO1_7: IC1.T9 (T9_GPMC_AD7/MMC1_DAT7//////GPIO1_7); also elsewhere on the board
GPIO1_12: IC1.T12 (T12_GPMC_AD12/LCD_DATA19/MMC1_DAT4/MMC2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); also elsewhere on the board
GPIO1_13: IC1.R12 (R12_GPMC_AD13/LCD_DATA18/MMC1_DAT5/MMC2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); also elsewhere on the board
GPIO1_14: IC1.V13 (V13_GPMC_AD14/LCD_DATA17/MMC1_DAT6/MMC2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); also elsewhere on the board
GPIO1_15: IC1.U13 (U13_GPMC_AD15/LCD_DATA16/MMC1_DAT7/MMC2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); also elsewhere on the board
GPIO1_16: IC1.V14 (V14_GPMC_A1/GMII2_RXDV/RGMII2_RCTL/MMC2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); also elsewhere on the board
GPIO1_28: IC1.U18 (U18_GPMC_BE1N/GMII2_COL/GPMC_CSN6/MMC2_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); also elsewhere on the board
GPIO1_29: IC1.V6 (V6_GPMC_CSN0/GPIO1_29); also elsewhere on the board
GPIO1_30: IC1.U9 (U9_GPMC_CSN1/GPMC_CLK/MMC1_CLK/PRT1EDIO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); also elsewhere on the board
GPIO1_31: IC1.V9 (V9_GPMC_CSN2/GPMC_BE1N/MMC1_CMD/PR1_EDI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); also elsewhere on the board
GPIO2_1: IC1.V12 (V12_GPMC_CLK/LCD_MEM_CLK/GPMC_WAIT1/MMC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); also elsewhere on the board
GPIO3_20: R278.2; also elsewhere on the board
JTAG_EMU0: IC1.C14 (C14_EMU0/GPIO3_7); also elsewhere on the board
JTAG_EMU1: IC1.B14 (B14_EMU1/GPIO3_8); also elsewhere on the board
JTAG_TCK: IC1.A12 (A12_TCK); also elsewhere on the board
JTAG_TDI: IC1.B11 (B11_TDI); also elsewhere on the board
JTAG_TDO: IC1.A11 (A11_TDO); also elsewhere on the board
JTAG_TMS: IC1.C11 (C11_TMS); also elsewhere on the board
JTAG_TRSTN: IC1.B10 (B10_NTRST); also elsewhere on the board
LDO_PGOOD: R283.1; also elsewhere on the board
LED_DISPLAY: IC1.U14 (U14_GPMC_A2/GMII2_TXD3/RGMII2_TD3/MMC2_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); also elsewhere on the board
MMC0_CLKO: IC1.G17 (G17_MMC0_CLK/GPMC_A24/UART3_CTSN/UART2_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); also elsewhere on the board
MMC0_CMD: IC1.G18 (G18_MMC0_CMD/GPMC_A25/UART3_RTSN/UART2_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); also elsewhere on the board
MMC0_DAT0: IC1.G16 (G16_MMC0_DAT0/GPMC_A23/UART5_RTSN/UART3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); also elsewhere on the board
MMC0_DAT1: IC1.G15 (G15_MMC0_DAT1/GPMC_A22/UART5_CTSN/UART3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); also elsewhere on the board
MMC0_DAT2: IC1.F18 (F18_MMC0_DAT2/GPMC_A21/UART4_RTSN/TIMER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); also elsewhere on the board
MMC0_DAT3: IC1.F17 (F17_MMC0_DAT3/GPMC_A20/UART4_CTSN/TIMER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); also elsewhere on the board
unnamed: C12.1, R222.1, Y7.1
unnamed: C13.1, R223.1, R224.2, Y8.1, Y9.1
OSC0_IN: C163.1, IC1.V10 (V10_OSC0_IN), R223.2, Y8.3, Y9.3
OSC0_OUT: IC1.U11 (U11_OSC0_OUT), R224.1
OSC1_IN: C11.2, IC1.A6 (A6_OSC1_IN), Y7.4 (2)
OSC1_OUT: IC1.A4 (A4_OSC1_OUT), R222.2
PDDR_A0: IC1.F3 (F3_DDR_A0), R225.2
PDDR_A1: IC1.H1 (H1_DDR_A1), R230.2
PDDR_A2: IC1.E4 (E4_DDR_A2), R233.2
PDDR_A3: IC1.C3 (C3_DDR_A3), R231.2
PDDR_A4: IC1.C2 (C2_DDR_A4), R234.2
PDDR_A5: IC1.B1 (B1_DDR_A5), R235.2
PDDR_A6: IC1.D5 (D5_DDR_A6), R236.2
PDDR_A7: IC1.E2 (E2_DDR_A7), R237.2
PDDR_A8: IC1.D4 (D4_DDR_A8), R238.2
PDDR_A9: IC1.C1 (C1_DDR_A9), R239.2
PDDR_A10: IC1.F4 (F4_DDR_A10), R240.2
PDDR_A11: IC1.F2 (F2_DDR_A11), R241.2
PDDR_A12: IC1.E3 (E3_DDR_A12), R242.2
PDDR_A13: IC1.H3 (H3_DDR_A13), R243.2
PDDR_BA0: IC1.C4 (C4_DDR_BA0), R244.2
PDDR_BA1: IC1.E1 (E1_DDR_BA1), R245.2
PDDR_BA2: IC1.B3 (B3_DDR_BA2), R246.2
PDDR_CASN: IC1.F1 (F1_DDR_CASN), R267.2
PDDR_CKE: IC1.G3 (G3_DDR_CKE), R265.2
PDDR_CLK: IC1.D2 (D2_DDR_CK), R263.2
PDDR_CLKN: IC1.D1 (D1_DDR_NCK), R264.2
PDDR_CSN: IC1.H2 (H2_DDR_CSN0), R266.2
PDDR_D0: IC1.M3 (M3_DDR_D0), R247.2
PDDR_D1: IC1.M4 (M4_DDR_D1), R248.2
PDDR_D2: IC1.N1 (N1_DDR_D2), R249.2
PDDR_D3: IC1.N2 (N2_DDR_D3), R250.2
PDDR_D4: IC1.N3 (N3_DDR_D4), R251.2
PDDR_D5: IC1.N4 (N4_DDR_D5), R252.2
PDDR_D6: IC1.P3 (P3_DDR_D6), R253.2
PDDR_D7: IC1.P4 (P4_DDR_D7), R254.2
PDDR_D8: IC1.J1 (J1_DDR_D8), R255.2
PDDR_D9: IC1.K1 (K1_DDR_D9), R256.2
PDDR_D10: IC1.K2 (K2_DDR_D10), R257.2
PDDR_D11: IC1.K3 (K3_DDR_D11), R258.2
PDDR_D12: IC1.K4 (K4_DDR_D12), R259.2
PDDR_D13: IC1.L3 (L3_DDR_D13), R260.2
PDDR_D14: IC1.L4 (L4_DDR_D14), R261.2
PDDR_D15: IC1.M1 (M1_DDR_D15), R262.2
PDDR_DQM0: IC1.M2 (M2_DDR_DQM0), R270.2
PDDR_DQM1: IC1.J2 (J2_DDR_DQM1), R273.2
PDDR_DQS0: IC1.P1 (P1_DDR_DQS0), R271.2
PDDR_DQS1: IC1.L1 (L1_DDR_DQS1), R274.2
PDDR_DQSN0: IC1.P2 (P2_DDR_DQSN0), R272.2
PDDR_DQSN1: IC1.L2 (L2_DDR_DQSN1), R227.2
PDDR_ODT: IC1.G1 (G1_DDR_ODT), R228.2
PDDR_RASN: IC1.G4 (G4_DDR_RASN), R268.2
PDDR_WEN: IC1.B2 (B2_DDR_WEN), R269.2
PMIC_INT: IC1.B18 (B18_NNMI); also elsewhere on the board
PMIC_PGOOD: C167.1, IC1.B15 (B15_PORZ), R279.2; also elsewhere on the board
RTC_PORZ: IC1.B5 (B5_RTC_PORZ), R281.1, R282.1, R283.2
SYS_RESETN: IC1.A10 (A10_NRESET_INOUT), R275.1, R276.1; also elsewhere on the board
SYS_WARMRESETN: R275.2; also elsewhere on the board
TIMER4: IC1.R7 (R7_GPMC_ADVN_ALE/TIMER4/GPIO2_2); also elsewhere on the board
TIMER5: IC1.T6 (T6_GPMC_BE0N_CLE/TIMER5/GPIO2_5); also elsewhere on the board
TIMER6: IC1.U6 (U6_GPMC_WEN/TIMER6/GPIO2_4); also elsewhere on the board
TIMER7: IC1.T7 (T7_GPMC_OEN_REN/TIMER7/EMU4/GPIO2_3); also elsewhere on the board
UART4_RXD: IC1.T17 (T17_GPMC_WAIT0/GM112_CRS/GPMC_CSN4/RMII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); also elsewhere on the board
UART4_TXD: IC1.U17 (U17_GPMC_WPN/GMII2_RXERR/GPMC_CSN5/RMII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); also elsewhere on the board
USB1_OC: IC1.V17 (V17_GPMC_A11/GMII2_RXD0/RGMII2_RD0/RMII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); also elsewhere on the board
USR0: IC1.U15 (U15_GPMC_A6/GMII2_TXCLK/RGMII2_TCLK/MMC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); also elsewhere on the board
USR1: IC1.T15 (T15_GPMC_A7/GMII2_RXCLK/RGMII2_RCLK/MMC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); also elsewhere on the board
USR2: IC1.V16 (V16_GPMC_A8/GMII2_RXD3/RGMII2_RD3/MMC2_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); also elsewhere on the board
USR3: IC1.U16 (U16_GPMC_A9/GMII2_RXD2/RGMII2_RD2/MMC2_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); also elsewhere on the board
VDDS_DDR: R226.1; also elsewhere on the board
VDD_3V3A: R276.2; also elsewhere on the board
VRTC: C168.1, U4.1 (1A), U4.2 (1B), U4.8 (VCC); also elsewhere on the board
VRTC_DET: R280.2, U4.7 (1Y)
VRTC_DETB: C169.1, R280.1, U4.5 (2A), U4.6 (2B)
VRTC_DET_OUT: R281.2, U4.3 (2Y)
XDMA_EVENT_INTR0: IC1.A15 (A15_EVENT_INTR0/TIMER4/CLKOUT1/SPI1_CS1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); also elsewhere on the board
