kylehagin/AM3358_Schematic/DELTA_7_25_2016.brd

## EAGLE design DELTA_7_25_2016.brd (continued)

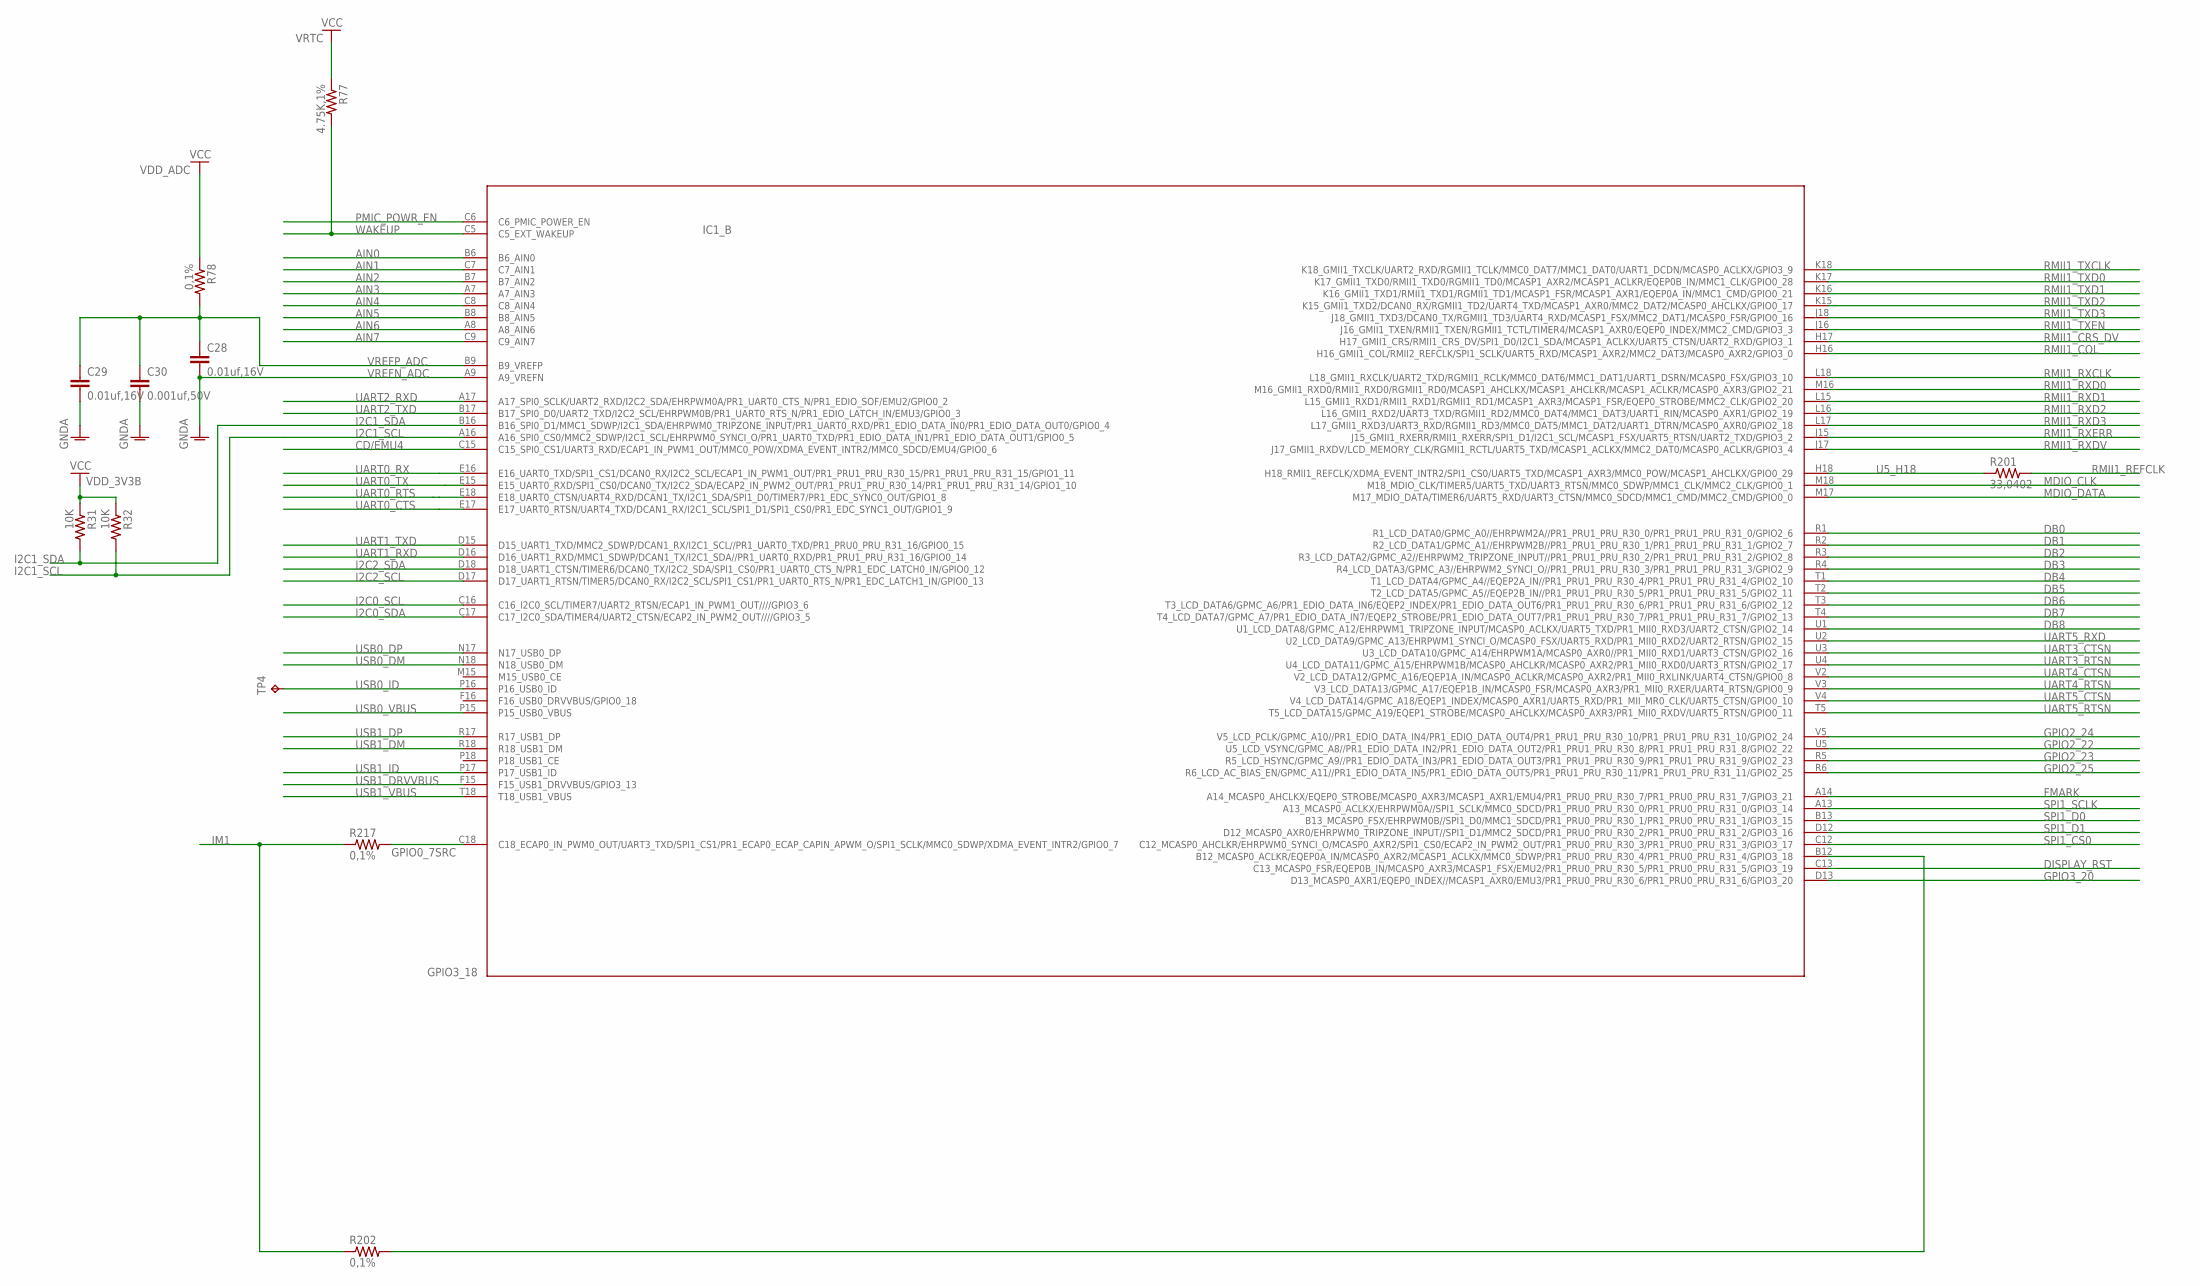
[picture p4: schematic DELTA_7_25_2016.sch, sheet 4]

Parts:
C28, C29: 0.01uf,16V; C0402
C30: 0.001uf,50V; C0402
IC1: AM335X_ZCZ; ZCZ_S-PBGA-N324
R31, R32: 10K; R0402
R77: 4.75K,1%; R0402
R78, R202, R217: 0,1%; R0402
R201: 33,0402; R0402
TP4: TPB1,27; B1,27

Connections:
AIN0: IC1.B6 (B6_AIN0); also elsewhere on the board
AIN1: IC1.C7 (C7_AIN1); also elsewhere on the board
AIN2: IC1.B7 (B7_AIN2); also elsewhere on the board
AIN3: IC1.A7 (A7_AIN3); also elsewhere on the board
AIN4: IC1.C8 (C8_AIN4); also elsewhere on the board
AIN5: IC1.B8 (B8_AIN5); also elsewhere on the board
AIN6: IC1.A8 (A8_AIN6); also elsewhere on the board
AIN7: IC1.C9 (C9_AIN7); also elsewhere on the board
CD/EMU4: IC1.C15 (C15_SPI0_CS1/UART3_RXD/ECAP1_IN_PWM1_OU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); also elsewhere on the board
DB0: IC1.R1 (R1_LCD_DATA0/GPMC_A0//EHRPWM2A//PR1_PRU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); also elsewhere on the board
DB1: IC1.R2 (R2_LCD_DATA1/GPMC_A1//EHRPWM2B//PR1_PRU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); also elsewhere on the board
DB2: IC1.R3 (R3_LCD_DATA2/GPMC_A2//EHRPWM2_TRIPZONE_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); also elsewhere on the board
DB3: IC1.R4 (R4_LCD_DATA3/GPMC_A3//EHRPWM2_SYNCI_O//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); also elsewhere on the board
DB4: IC1.T1 (T1_LCD_DATA4/GPMC_A4//EQEP2A_IN//PR1_PR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); also elsewhere on the board
DB5: IC1.T2 (T2_LCD_DATA5/GPMC_A5//EQEP2B_IN//PR1_PR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); also elsewhere on the board
DB6: IC1.T3 (T3_LCD_DATA6/GPMC_A6/PR1_EDIO_DATA_IN6/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); also elsewhere on the board
DB7: IC1.T4 (T4_LCD_DATA7/GPMC_A7/PR1_EDIO_DATA_IN7/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); also elsewhere on the board
DB8: IC1.U1 (U1_LCD_DATA8/GPMC_A12/EHRPWM1_TRIPZONE_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); also elsewhere on the board
DISPLAY_RST: IC1.C13 (C13_MCASP0_FSR/EQEP0B_IN/MCASP0_AXR3/MC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); also elsewhere on the board
FMARK: IC1.A14 (A14_MCASP0_AHCLKX/EQEP0_STROBE/MCASP0_A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); also elsewhere on the board
GNDA: C29.2, C30.2; also elsewhere on the board
GPIO0_7SRC: IC1.C18 (C18_ECAP0_IN_PWM0_OUT/UART3_TXD/SPI1_CS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), R217.2
GPIO2_22: IC1.U5 (U5_LCD_VSYNC/GPMC_A8//PR1_EDIO_DATA_IN2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); also elsewhere on the board
GPIO2_23: IC1.R5 (R5_LCD_HSYNC/GPMC_A9//PR1_EDIO_DATA_IN3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); also elsewhere on the board
GPIO2_24: IC1.V5 (V5_LCD_PCLK/GPMC_A10//PR1_EDIO_DATA_IN4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); also elsewhere on the board
GPIO2_25: IC1.R6 (R6_LCD_AC_BIAS_EN/GPMC_A11//PR1_EDIO_DA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); also elsewhere on the board
GPIO3_18: IC1.B12 (B12_MCASP0_ACLKR/EQEP0A_IN/MCASP0_AXR2/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), R202.2
GPIO3_20: IC1.D13 (D13_MCASP0_AXR1/EQEP0_INDEX//MCASP1_AXR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); also elsewhere on the board
I2C0_SCL: IC1.C16 (C16_I2C0_SCL/TIMER7/UART2_RTSN/ECAP1_IN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); also elsewhere on the board
I2C0_SDA: IC1.C17 (C17_I2C0_SDA/TIMER4/UART2_CTSN/ECAP2_IN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); also elsewhere on the board
I2C1_SCL: IC1.A16 (A16_SPI0_CS0/MMC2_SDWP/I2C1_SCL/EHRPWM0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), R32.2; also elsewhere on the board
I2C1_SDA: IC1.B16 (B16_SPI0_D1/MMC1_SDWP/I2C1_SDA/EHRPWM0_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), R31.2; also elsewhere on the board
I2C2_SCL: IC1.D17 (D17_UART1_RTSN/TIMER5/DCAN0_RX/I2C2_SCL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); also elsewhere on the board
I2C2_SDA: IC1.D18 (D18_UART1_CTSN/TIMER6/DCAN0_TX/I2C2_SDA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); also elsewhere on the board
IM1: R202.1, R217.1; also elsewhere on the board
MDIO_CLK: IC1.M18 (M18_MDIO_CLK/TIMER5/UART5_TXD/UART3_RTS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); also elsewhere on the board
MDIO_DATA: IC1.M17 (M17_MDIO_DATA/TIMER6/UART5_RXD/UART3_CT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); also elsewhere on the board
PMIC_POWR_EN: IC1.C6 (C6_PMIC_POWER_EN); also elsewhere on the board
RMII1_COL: IC1.H16 (H16_GMII1_COL/RMII2_REFCLK/SPI1_SCLK/UA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); also elsewhere on the board
RMII1_CRS_DV: IC1.H17 (H17_GMII1_CRS/RMII1_CRS_DV/SPI1_D0/I2C1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); also elsewhere on the board
RMII1_REFCLK: R201.2; also elsewhere on the board
RMII1_RXCLK: IC1.L18 (L18_GMII1_RXCLK/UART2_TXD/RGMII1_RCLK/M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); also elsewhere on the board
RMII1_RXD0: IC1.M16 (M16_GMII1_RXD0/RMII1_RXD0/RGMII1_RD0/MC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); also elsewhere on the board
RMII1_RXD1: IC1.L15 (L15_GMII1_RXD1/RMII1_RXD1/RGMII1_RD1/MC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); also elsewhere on the board
RMII1_RXD2: IC1.L16 (L16_GMII1_RXD2/UART3_TXD/RGMII1_RD2/MMC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); also elsewhere on the board
RMII1_RXD3: IC1.L17 (L17_GMII1_RXD3/UART3_RXD/RGMII1_RD3/MMC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); also elsewhere on the board
RMII1_RXDV: IC1.J17 (J17_GMII1_RXDV/LCD_MEMORY_CLK/RGMII1_RC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); also elsewhere on the board
RMII1_RXERR: IC1.J15 (J15_GMII1_RXERR/RMII1_RXERR/SPI1_D1/I2C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); also elsewhere on the board
RMII1_TXCLK: IC1.K18 (K18_GMII1_TXCLK/UART2_RXD/RGMII1_TCLK/M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); also elsewhere on the board
RMII1_TXD0: IC1.K17 (K17_GMII1_TXD0/RMII1_TXD0/RGMII1_TD0/MC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); also elsewhere on the board
RMII1_TXD1: IC1.K16 (K16_GMII1_TXD1/RMII1_TXD1/RGMII1_TD1/MC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); also elsewhere on the board
RMII1_TXD2: IC1.K15 (K15_GMII1_TXD2/DCAN0_RX/RGMII1_TD2/UART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); also elsewhere on the board
RMII1_TXD3: IC1.J18 (J18_GMII1_TXD3/DCAN0_TX/RGMII1_TD3/UART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); also elsewhere on the board
RMII1_TXEN: IC1.J16 (J16_GMII1_TXEN/RMII1_TXEN/RGMII1_TCTL/T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); also elsewhere on the board
SPI1_CS0: IC1.C12 (C12_MCASP0_AHCLKR/EHRPWM0_SYNCI_O/MCASP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); also elsewhere on the board
SPI1_D0: IC1.B13 (B13_MCASP0_FSX/EHRPWM0B//SPI1_D0/MMC1_S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); also elsewhere on the board
SPI1_D1: IC1.D12 (D12_MCASP0_AXR0/EHRPWM0_TRIPZONE_INPUT/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); also elsewhere on the board
SPI1_SCLK: IC1.A13 (A13_MCASP0_ACLKX/EHRPWM0A//SPI1_SCLK/MM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); also elsewhere on the board
U5_H18: IC1.H18 (H18_RMII1_REFCLK/XDMA_EVENT_INTR2/SPI1_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), R201.1
UART0_CTS: IC1.E17 (E17_UART0_RTSN/UART4_TXD/DCAN1_RX/I2C1_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); also elsewhere on the board
UART0_RTS: IC1.E18 (E18_UART0_CTSN/UART4_RXD/DCAN1_TX/I2C1_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); also elsewhere on the board
UART0_RX: IC1.E16 (E16_UART0_TXD/SPI1_CS1/DCAN0_RX/I2C2_SC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); also elsewhere on the board
UART0_TX: IC1.E15 (E15_UART0_RXD/SPI1_CS0/DCAN0_TX/I2C2_SD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); also elsewhere on the board
UART1_RXD: IC1.D16 (D16_UART1_RXD/MMC1_SDWP/DCAN1_TX/I2C1_S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); also elsewhere on the board
UART1_TXD: IC1.D15 (D15_UART1_TXD/MMC2_SDWP/DCAN1_RX/I2C1_S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); also elsewhere on the board
UART2_RXD: IC1.A17 (A17_SPI0_SCLK/UART2_RXD/I2C2_SDA/EHRPWM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); also elsewhere on the board
UART2_TXD: IC1.B17 (B17_SPI0_D0/UART2_TXD/I2C2_SCL/EHRPWM0B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); also elsewhere on the board
UART3_CTSN: IC1.U3 (U3_LCD_DATA10/GPMC_A14/EHRPWM1A/MCASP0_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); also elsewhere on the board
UART3_RTSN: IC1.U4 (U4_LCD_DATA11/GPMC_A15/EHRPWM1B/MCASP0_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); also elsewhere on the board
UART4_CTSN: IC1.V2 (V2_LCD_DATA12/GPMC_A16/EQEP1A_IN/MCASP0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); also elsewhere on the board
UART4_RTSN: IC1.V3 (V3_LCD_DATA13/GPMC_A17/EQEP1B_IN/MCASP0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); also elsewhere on the board
UART5_CTSN: IC1.V4 (V4_LCD_DATA14/GPMC_A18/EQEP1_INDEX/MCAS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); also elsewhere on the board
UART5_RTSN: IC1.T5 (T5_LCD_DATA15/GPMC_A19/EQEP1_STROBE/MCA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); also elsewhere on the board
UART5_RXD: IC1.U2 (U2_LCD_DATA9/GPMC_A13/EHRPWM1_SYNCI_O/M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); also elsewhere on the board
USB0_DM: IC1.N18 (N18_USB0_DM); also elsewhere on the board
USB0_DP: IC1.N17 (N17_USB0_DP); also elsewhere on the board
USB0_ID: IC1.P16 (P16_USB0_ID), TP4.TP
USB0_VBUS: IC1.P15 (P15_USB0_VBUS); also elsewhere on the board
USB1_DM: IC1.R18 (R18_USB1_DM); also elsewhere on the board
USB1_DP: IC1.R17 (R17_USB1_DP); also elsewhere on the board
USB1_DRVVBUS: IC1.F15 (F15_USB1_DRVVBUS/GPIO3_13); also elsewhere on the board
USB1_ID: IC1.P17 (P17_USB1_ID); also elsewhere on the board
USB1_VBUS: IC1.T18 (T18_USB1_VBUS); also elsewhere on the board
VDD_3V3B: R31.1, R32.1; also elsewhere on the board
VDD_ADC: R78.1; also elsewhere on the board
VREFN_ADC: C28.2, IC1.A9 (A9_VREFN)
VREFP_ADC: C28.1, C29.1, C30.1, IC1.B9 (B9_VREFP), R78.2
VRTC: R77.1; also elsewhere on the board
WAKEUP: IC1.C5 (C5_EXT_WAKEUP), R77.2; also elsewhere on the board

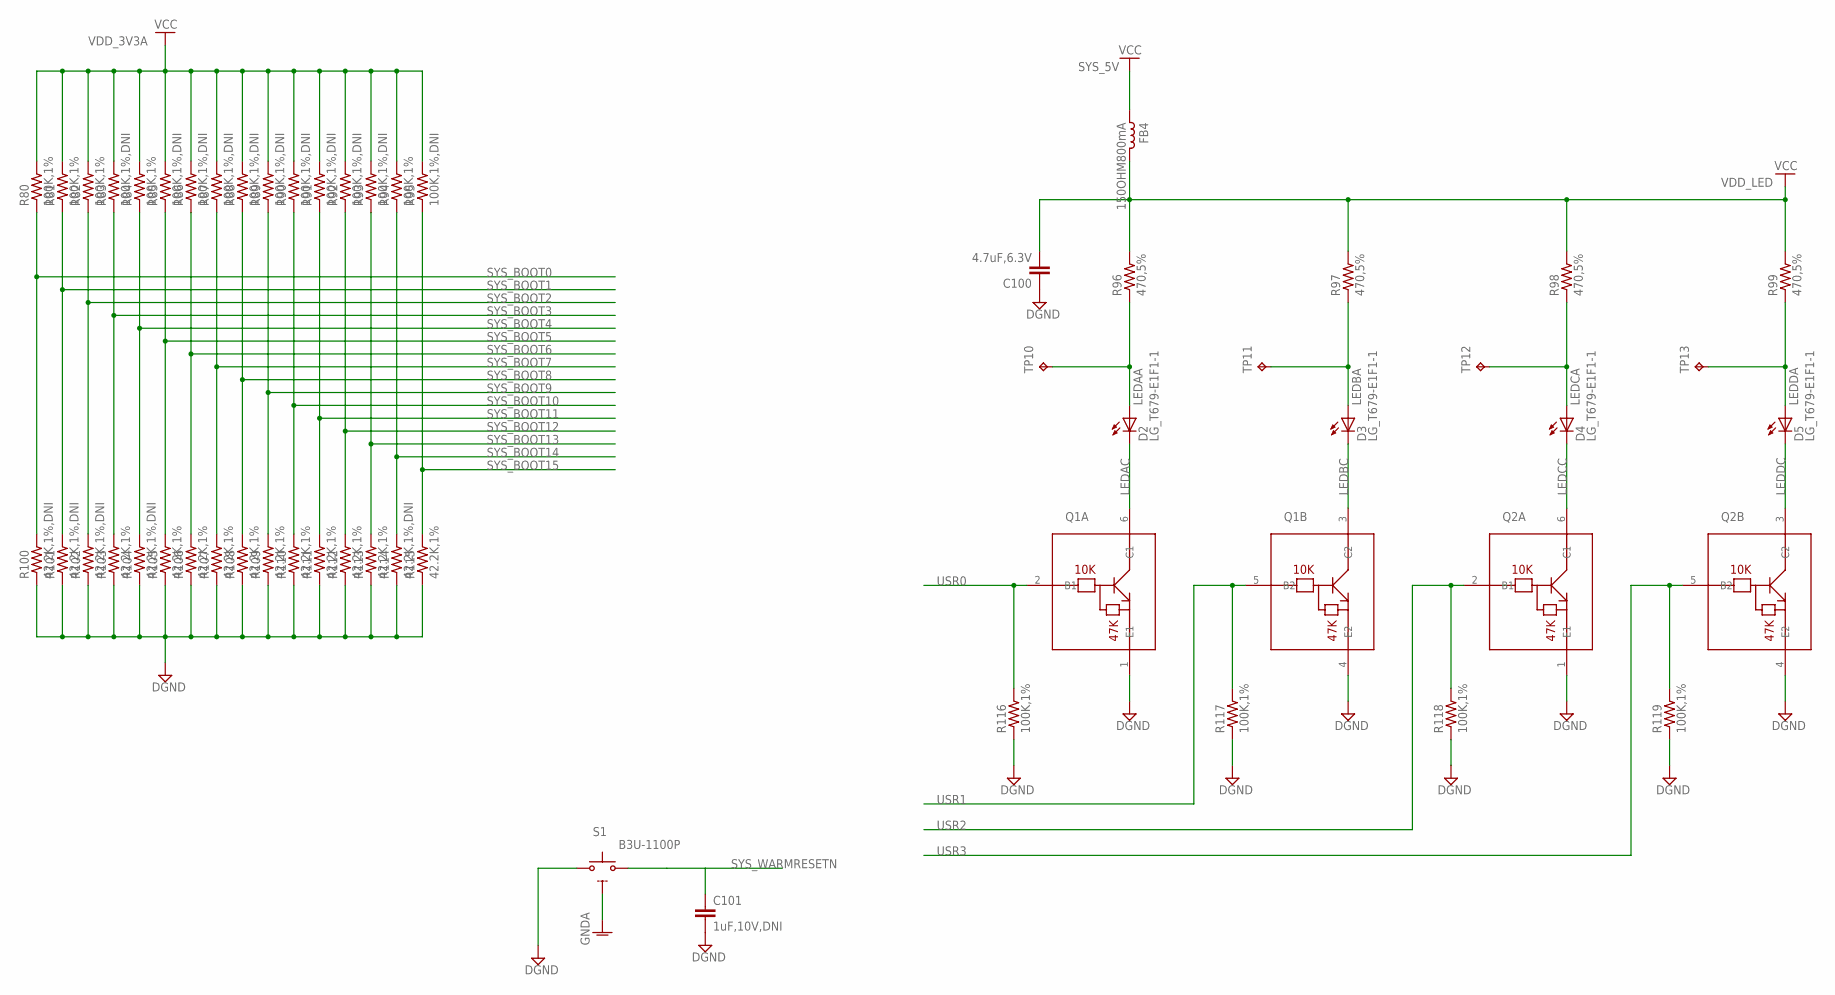
[picture p5: schematic DELTA_7_25_2016.sch, sheet 5]

Parts:
C100: 4.7uF,6.3V; C0402
C101: 1uF,10V,DNI; C0805
D2, D3, D4, D5: LG_T679-E1F1-1; PLCC2
FB4: 150OHM800mA; L0603
Q1, Q2: DMC56404
R80, R81, R82, R84, R94, R116, R117, R118, R119: 100K,1%; R0402
R83, R85, R86, R87, R88, R89, R90, R91, R92, R93, R95: 100K,1%,DNI; R0402
R96, R97, R98, R99: 470,5%; R0402
R100, R101, R102, R104, R114: 42.2K,1%,DNI; R0402
R103, R105, R106, R107, R108, R109, R110, R111, R112, R113, R115: 42.2K,1%; R0402
S1: B3U-1100P
TP10, TP11, TP12, TP13: TPB1,27; B1,27

Connections:
DGND: C100.1, C101.2, Q1.1 (E1), Q1.4 (E2), Q2.1 (E1), Q2.4 (E2), R100.1, R101.1, R102.1, R103.1, R104.1, R105.1, R106.1, R107.1, R108.1, R109.1, R110.1, R111.1, R112.1, R113.1, R114.1, R115.1, R116.1, R117.1, R118.1, R119.1, S1.1; also elsewhere on the board
GNDA: S1.S (G); also elsewhere on the board
LEDAA: D2.A, R96.1, TP10.TP
LEDAC: D2.C, Q1.6 (C1)
LEDBA: D3.A, R97.1, TP11.TP
LEDBC: D3.C, Q1.3 (C2)
LEDCA: D4.A, R98.1, TP12.TP
LEDCC: D4.C, Q2.6 (C1)
LEDDA: D5.A, R99.1, TP13.TP
LEDDC: D5.C, Q2.3 (C2)
SYS_5V: FB4.2; also elsewhere on the board
SYS_BOOT0: R80.1, R100.2
SYS_BOOT1: R81.1, R101.2
SYS_BOOT2: R82.1, R102.2
SYS_BOOT3: R83.1, R103.2
SYS_BOOT4: R84.1, R104.2
SYS_BOOT5: R85.1, R105.2
SYS_BOOT6: R86.1, R106.2
SYS_BOOT7: R87.1, R107.2
SYS_BOOT8: R88.1, R108.2
SYS_BOOT9: R89.1, R109.2
SYS_BOOT10: R90.1, R110.2
SYS_BOOT11: R91.1, R111.2
SYS_BOOT12: R92.1, R112.2
SYS_BOOT13: R93.1, R113.2
SYS_BOOT14: R94.1, R114.2
SYS_BOOT15: R95.1, R115.2
SYS_WARMRESETN: C101.1, S1.2 (S); also elsewhere on the board
USR0: Q1.2 (B1), R116.2; also elsewhere on the board
USR1: Q1.5 (B2), R117.2; also elsewhere on the board
USR2: Q2.2 (B1), R118.2; also elsewhere on the board
USR3: Q2.5 (B2), R119.2; also elsewhere on the board
VDD_3V3A: R80.2, R81.2, R82.2, R83.2, R84.2, R85.2, R86.2, R87.2, R88.2, R89.2, R90.2, R91.2, R92.2, R93.2, R94.2, R95.2; also elsewhere on the board
VDD_LED: C100.2, FB4.1, R96.2, R97.2, R98.2, R99.2

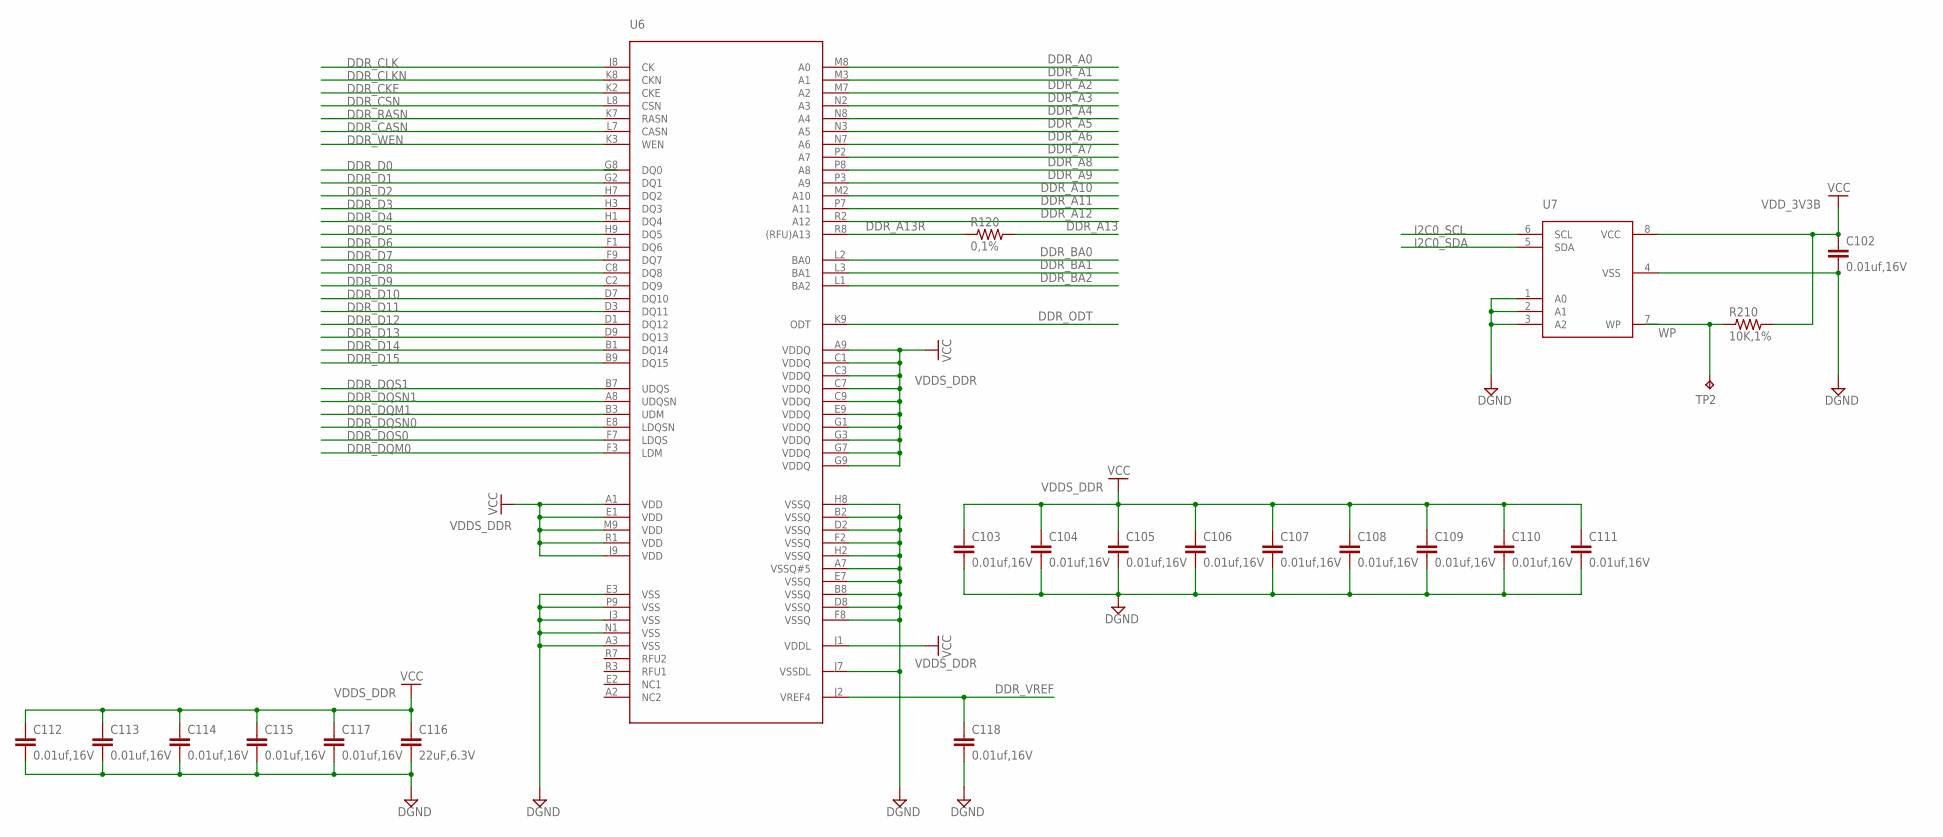
[picture p6: schematic DELTA_7_25_2016.sch, sheet 6]

Parts:
C102, C103, C104, C105, C106, C107, C108, C109, C110, C111, C112, C113, C114, C115, C117, C118: 0.01uf,16V; C0402
C116: 22uF,6.3V; C0402
R120: 0,1%; R0402
R210: 10K,1%; R0402
TP2: TPB1,27; B1,27
U6: MT47H128M16RT-25E:C; 90FBGA
U7: CAT24C256W; SOIC8

Connections:
DDR_A0: U6.M8 (A0); also elsewhere on the board
DDR_A1: U6.M3 (A1); also elsewhere on the board
DDR_A2: U6.M7 (A2); also elsewhere on the board
DDR_A3: U6.N2 (A3); also elsewhere on the board
DDR_A4: U6.N8 (A4); also elsewhere on the board
DDR_A5: U6.N3 (A5); also elsewhere on the board
DDR_A6: U6.N7 (A6); also elsewhere on the board
DDR_A7: U6.P2 (A7); also elsewhere on the board
DDR_A8: U6.P8 (A8); also elsewhere on the board
DDR_A9: U6.P3 (A9); also elsewhere on the board
DDR_A10: U6.M2 (A10); also elsewhere on the board
DDR_A11: U6.P7 (A11); also elsewhere on the board
DDR_A12: U6.R2 (A12); also elsewhere on the board
DDR_A13: R120.2; also elsewhere on the board
DDR_A13R: R120.1, U6.R8 ((RFU)A13)
DDR_BA0: U6.L2 (BA0); also elsewhere on the board
DDR_BA1: U6.L3 (BA1); also elsewhere on the board
DDR_BA2: U6.L1 (BA2); also elsewhere on the board
DDR_CASN: U6.L7 (CASN); also elsewhere on the board
DDR_CKE: U6.K2 (CKE); also elsewhere on the board
DDR_CLK: U6.J8 (CK); also elsewhere on the board
DDR_CLKN: U6.K8 (CKN); also elsewhere on the board
DDR_CSN: U6.L8 (CSN); also elsewhere on the board
DDR_D1: U6.G2 (DQ1); also elsewhere on the board
DDR_D2: U6.H7 (DQ2); also elsewhere on the board
DDR_D3: U6.H3 (DQ3); also elsewhere on the board
DDR_D4: U6.H1 (DQ4); also elsewhere on the board
DDR_D5: U6.H9 (DQ5); also elsewhere on the board
DDR_D6: U6.F1 (DQ6); also elsewhere on the board
DDR_D7: U6.F9 (DQ7); also elsewhere on the board
DDR_D8: U6.C8 (DQ8); also elsewhere on the board
DDR_D9: U6.C2 (DQ9); also elsewhere on the board
DDR_D10: U6.D7 (DQ10); also elsewhere on the board
DDR_D11: U6.D3 (DQ11); also elsewhere on the board
DDR_D12: U6.D1 (DQ12); also elsewhere on the board
DDR_D13: U6.D9 (DQ13); also elsewhere on the board
DDR_D14: U6.B1 (DQ14); also elsewhere on the board
DDR_D15: U6.B9 (DQ15); also elsewhere on the board
DDR_DQM0: U6.F3 (LDM); also elsewhere on the board
DDR_DQM1: U6.B3 (UDM); also elsewhere on the board
DDR_DQS0: U6.F7 (LDQS); also elsewhere on the board
DDR_DQS1: U6.B7 (UDQS); also elsewhere on the board
DDR_DQSN0: U6.E8 (LDQSN); also elsewhere on the board
DDR_DQSN1: U6.A8 (UDQSN); also elsewhere on the board
DDR_ODT: U6.K9 (ODT); also elsewhere on the board
DDR_RASN: U6.K7 (RASN); also elsewhere on the board
DDR_VREF: C118.1, U6.J2 (VREF4); also elsewhere on the board
DDR_WEN: U6.K3 (WEN); also elsewhere on the board
DGND: C102.2, C103.2, C104.2, C105.2, C106.2, C107.2, C108.2, C109.2, C110.2, C111.2, C112.2, C113.2, C114.2, C115.2, C116.2, C117.2, C118.2, U6.A3 (VSS), U6.A7 (VSSQ#5), U6.B2 (VSSQ), U6.B8 (VSSQ), U6.D2 (VSSQ), U6.D8 (VSSQ), U6.E3 (VSS), U6.E7 (VSSQ), U6.F2 (VSSQ), U6.F8 (VSSQ), U6.H2 (VSSQ), U6.H8 (VSSQ), U6.J3 (VSS), U6.J7 (VSSDL), U6.N1 (VSS), U6.P9 (VSS), U7.1 (A0), U7.2 (A1), U7.3 (A2), U7.4 (VSS); also elsewhere on the board
I2C0_SCL: U7.6 (SCL); also elsewhere on the board
I2C0_SDA: U7.5 (SDA); also elsewhere on the board
VDDS_DDR: C103.1, C104.1, C105.1, C106.1, C107.1, C108.1, C109.1, C110.1, C111.1, C112.1, C113.1, C114.1, C115.1, C116.1, C117.1, U6.A1 (VDD), U6.A9 (VDDQ), U6.C1 (VDDQ), U6.C3 (VDDQ), U6.C7 (VDDQ), U6.C9 (VDDQ), U6.E1 (VDD), U6.E9 (VDDQ), U6.G1 (VDDQ), U6.G3 (VDDQ), U6.G7 (VDDQ), U6.G9 (VDDQ), U6.J1 (VDDL), U6.J9 (VDD), U6.M9 (VDD), U6.R1 (VDD); also elsewhere on the board
VDD_3V3B: C102.1, R210.2, U7.8 (VCC); also elsewhere on the board
WP: R210.1, TP2.TP

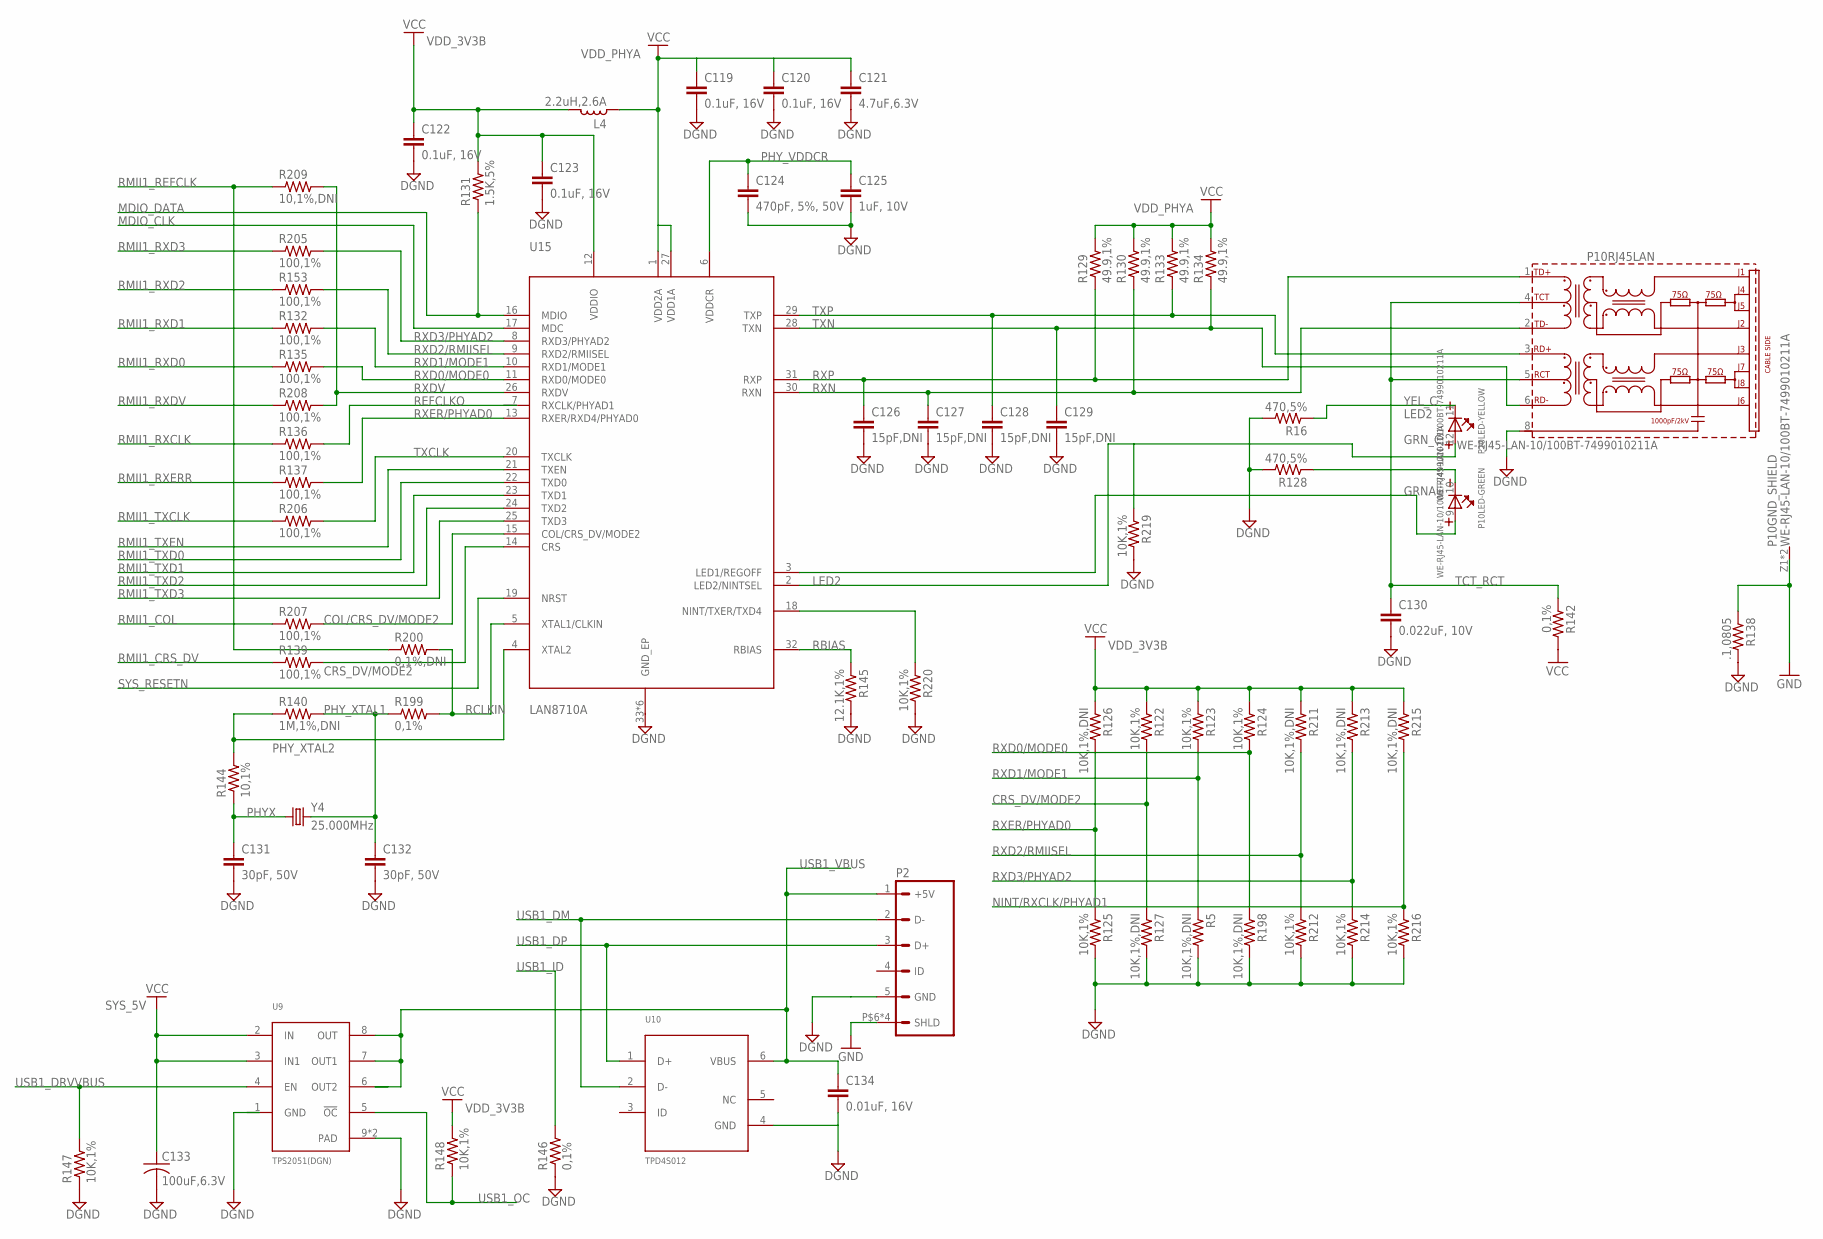
[picture p7: schematic DELTA_7_25_2016.sch, sheet 7]

Parts:
C119, C120, C122, C123: 0.1uF, 16V; C0402
C121: 4.7uF,6.3V; C0402
C124: 470pF, 5%, 50V; C0402
C125: 1uF, 10V; C0402
C126, C127, C128, C129: 15pF,DNI; C2.5-3
C130: 0.022uF, 10V; C0402
C131, C132: 30pF, 50V; C0402
C133: 100uF,6.3V; CAP_C
C134: 0.01uF, 16V; C0402
L4: 2.2uH,2.6A; L1008
P2: CON-MINI_USB-A; MINI-USB-A
P10: WE-RJ45-LAN-10/100BT-7499010211A; 74990-WITH-LED-TYPE2
R5, R126, R127, R198, R211, R213, R215: 10K,1%,DNI; R0402
R16, R128: 470,5%; R0402
R122, R123, R124, R125, R147, R148, R212, R214, R216, R219, R220: 10K,1%; R0402
R129, R130, R133, R134: 49.9,1%; R0402
R131: 1.5K,5%; R0402
R132, R135, R136, R137, R139, R153, R205, R206, R207, R208: 100,1%; R0402
R138: .1,0805; R0402
R140: 1M,1%,DNI; R0402
R142, R146, R199: 0,1%; R0402
R144: 10,1%; R0402
R145: 12.1K,1%; R0402
R200: 0,1%,DNI; R0402
R209: 10,1%,DNI; R0402
U9: TPS2051(DGN); DGN
U10: TPD4S012; DRY(R-PUSON-N6)
U15: LAN8710A; 32-QFN
Y4: 25.000MHz; HC49/S

Connections:
COL/CRS_DV/MODE2: R207.2, U15.15 (COL/CRS_DV/MODE2)
CRS_DV/MODE2: R122.2, R127.1, R139.2, U15.14 (CRS)
DGND: C119.2, C120.2, C121.2, C122.2, C123.2, C124.2, C125.2, C126.2, C127.2, C128.2, C129.2, C130.2, C131.2, C132.2, C133.- (2), C134.2, P2.5 (GND), P10.8 (SH), R5.2, R16.2, R125.2, R127.2, R128.2, R138.2, R145.2, R146.1, R147.1, R198.2, R212.2, R214.2, R216.2, R219.2, R220.2, U9.9 (PAD), U9.GND (PAD), U10.4 (GND), U15.33 (GND_EP), U15.W1 (GND_EP), U15.W2 (GND_EP), U15.W3 (GND_EP), U15.W4 (GND_EP), U15.W5 (GND_EP); also elsewhere on the board
GND: P2.P$6 (SHLD), P2.P$7 (SHLD), P2.P$8 (SHLD), P2.P$9 (SHLD), P10.Z1, P10.Z2, R138.1; also elsewhere on the board
GRNA: P10.9 (A), U15.3 (LED1/REGOFF)
GRN_C: P10.10 (K), R128.1
LED2: P10.12 (A), R219.1, U15.2 (LED2/NINTSEL)
MDIO_CLK: U15.17 (MDC); also elsewhere on the board
MDIO_DATA: R131.1, U15.16 (MDIO); also elsewhere on the board
unnamed: R220.1, U15.18 (NINT/TXER/TXD4)
NINT/RXCLK/PHYAD1: R215.2, R216.1
PHYX: C131.1, R144.1, Y4.1
PHY_VDDCR: C124.1, C125.1, U15.6 (VDDCR)
PHY_XTAL1: C132.1, R140.2, R199.1, Y4.2
PHY_XTAL2: R140.1, R144.2, U15.4 (XTAL2)
RBIAS: R145.1, U15.32 (RBIAS)
RCLKIN: R199.2, R200.2, U15.5 (XTAL1/CLKIN)
REFCLKO: R136.2
RMII1_COL: R207.1; also elsewhere on the board
RMII1_CRS_DV: R139.1; also elsewhere on the board
RMII1_REFCLK: R200.1, R209.1; also elsewhere on the board
RMII1_RXCLK: R136.1; also elsewhere on the board
RMII1_RXD0: R135.1; also elsewhere on the board
RMII1_RXD1: R132.1; also elsewhere on the board
RMII1_RXD2: R153.1; also elsewhere on the board
RMII1_RXD3: R205.1; also elsewhere on the board
RMII1_RXDV: R208.1; also elsewhere on the board
RMII1_RXERR: R137.1; also elsewhere on the board
RMII1_TXCLK: R206.1; also elsewhere on the board
RMII1_TXD0: U15.22 (TXD0); also elsewhere on the board
RMII1_TXD1: U15.23 (TXD1); also elsewhere on the board
RMII1_TXD2: U15.24 (TXD2); also elsewhere on the board
RMII1_TXD3: U15.25 (TXD3); also elsewhere on the board
RMII1_TXEN: U15.21 (TXEN); also elsewhere on the board
RXD0/MODE0: R124.2, R135.2, R198.1, U15.11 (RXD0/MODE0)
RXD1/MODE1: R5.1, R123.2, R132.2, U15.10 (RXD1/MODE1)
RXD2/RMIISEL: R153.2, R211.2, R212.1, U15.9 (RXD2/RMIISEL)
RXD3/PHYAD2: R205.2, R213.2, R214.1, U15.8 (RXD3/PHYAD2)
RXDV: R208.2, R209.2, U15.26 (RXDV)
RXER/PHYAD0: R125.1, R126.2, R137.2, U15.13 (RXER/RXD4/PHYAD0)
RXN: C127.1, P10.2 (TD-), R130.1, U15.30 (RXN)
RXP: C126.1, P10.1 (TD+), R129.1, U15.31 (RXP)
SYS_5V: C133.+ (1), U9.2 (IN), U9.3 (IN1); also elsewhere on the board
SYS_RESETN: U15.19 (NRST); also elsewhere on the board
TCT_RCT: C130.1, P10.4 (TCT), P10.5 (RCT), R142.1
TXCLK: R206.2, U15.20 (TXCLK)
TXN: C129.1, P10.6 (RD-), R134.1, U15.28 (TXN)
TXP: C128.1, P10.3 (RD+), R133.1, U15.29 (TXP)
USB1_DM: P2.2 (D-), U10.2 (D-); also elsewhere on the board
USB1_DP: P2.3 (D+), U10.1 (D+); also elsewhere on the board
USB1_DRVVBUS: R147.2, U9.4 (EN); also elsewhere on the board
USB1_ID: R146.2; also elsewhere on the board
USB1_OC: R148.1, U9.5 (!OC); also elsewhere on the board
USB1_VBUS: C134.1, P2.1 (+5V), U9.6 (OUT2), U9.7 (OUT1), U9.8 (OUT), U10.6 (VBUS); also elsewhere on the board
VCC: R142.2; also elsewhere on the board
VDD_3V3B: C122.1, C123.1, L4.1, R122.1, R123.1, R124.1, R126.1, R131.2, R148.2, R211.1, R213.1, R215.1, U15.12 (VDDIO); also elsewhere on the board
VDD_PHYA: C119.1, C120.1, C121.1, L4.2, R129.2, R130.2, R133.2, R134.2, U15.1 (VDD2A), U15.27 (VDD1A)
YEL_C: P10.11 (K), R16.1

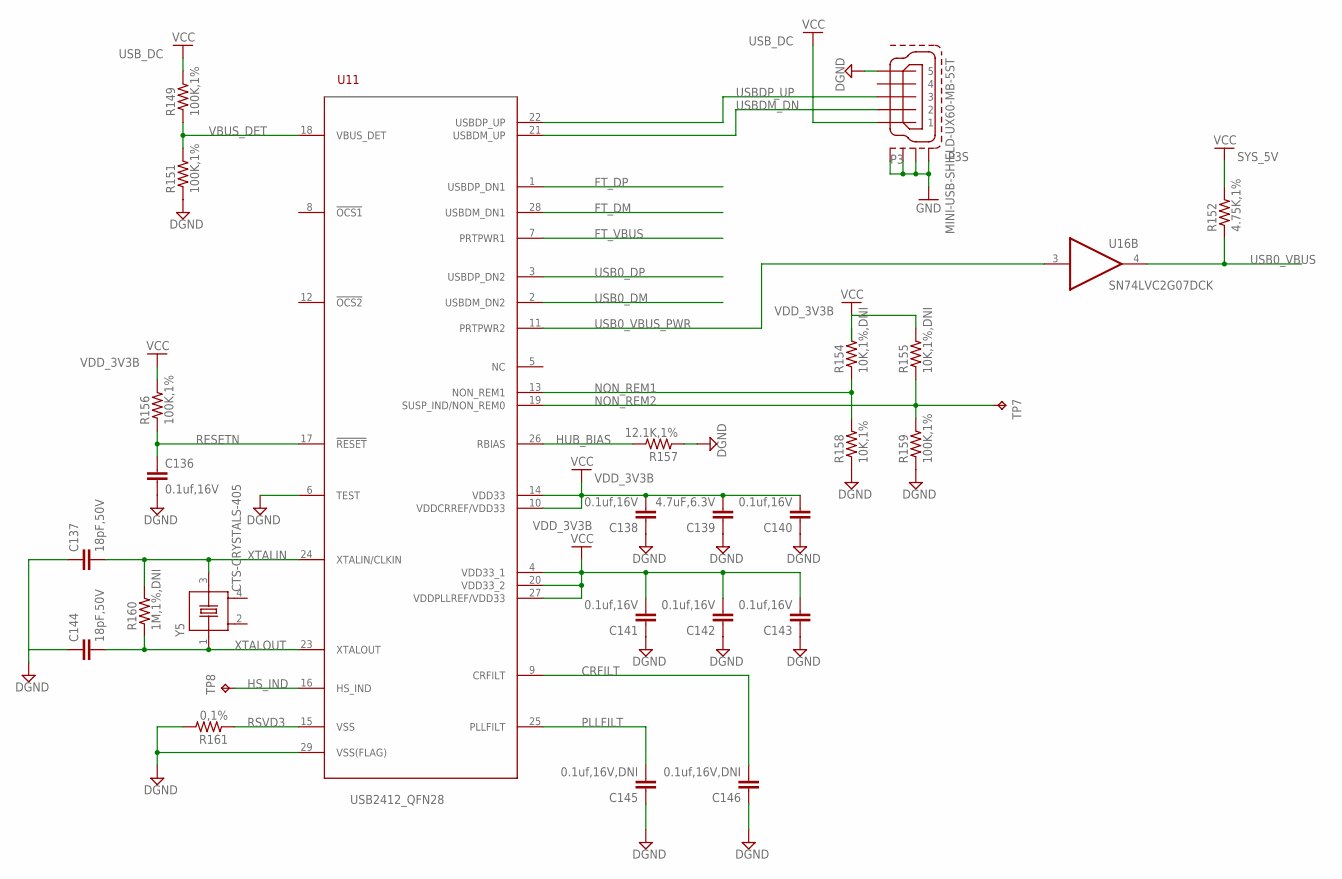
[picture p8: schematic DELTA_7_25_2016.sch, sheet 8]

Parts:
C136, C138, C140, C141, C142, C143: 0.1uf,16V; C402
C137, C144: 18pF,50V; C402
C139: 4.7uF,6.3V; C402
C145, C146: 0.1uf,16V,DNI; C805
P3: MINI-USB-SHIELD-UX60-MB-5ST; UX60-MB-5ST
R149, R151, R156, R159: 100K,1%; R0402
R152: 4.75K,1%; R0402
R154, R155: 10K,1%,DNI; R0402
R157: 12.1K,1%; R0402
R158: 10K,1%; R0402
R160: 1M,1%,DNI; R0402
R161: 0,1%; R0402
TP7, TP8: TPB1,27; B1,27
U11: USB2412_QFN28; QFN28
U16: SN74LVC2G07DCK; DCK(R-PDSO-G6)
Y5: CTS-CRYSTALS-405; CTS-405

Connections:
CRFILT: C146.2, U11.9 (CRFILT)
DGND: C136.2, C137.1, C138.1, C139.1, C140.1, C141.1, C142.1, C143.1, C144.1, C145.1, C146.1, P3.5, R151.1, R157.1, R158.1, R159.1, R161.2, U11.6 (TEST), U11.29 (VSS(FLAG)); also elsewhere on the board
FT_DM: U11.28 (USBDM_DN1); also elsewhere on the board
FT_DP: U11.1 (USBDP_DN1); also elsewhere on the board
FT_VBUS: U11.7 (PRTPWR1); also elsewhere on the board
GND: P3.M1 (S1), P3.M2 (S2), P3.M3 (S3), P3.M4 (S4); also elsewhere on the board
HS_IND: TP8.TP, U11.16 (HS_IND)
HUB_BIAS: R157.2, U11.26 (RBIAS)
NON_REM1: R154.1, R158.2, U11.13 (NON_REM1)
NON_REM2: R155.1, R159.2, TP7.TP, U11.19 (SUSP_IND/NON_REM0)
PLLFILT: C145.2, U11.25 (PLLFILT)
RESETN: C136.1, R156.1, U11.17 (!RESET)
RSVD3: R161.1, U11.15 (VSS)
SYS_5V: R152.2; also elsewhere on the board
USB0_DM: U11.2 (USBDM_DN2); also elsewhere on the board
USB0_DP: U11.3 (USBDP_DN2); also elsewhere on the board
USB0_VBUS: R152.1, U16.4 (O); also elsewhere on the board
USB0_VBUS_PWR: U11.11 (PRTPWR2), U16.3 (I)
USBDM_DN: P3.2, U11.21 (USBDM_UP)
USBDP_UP: P3.3, U11.22 (USBDP_UP)
USB_DC: P3.1, R149.2; also elsewhere on the board
VBUS_DET: R149.1, R151.2, U11.18 (VBUS_DET)
VDD_3V3B: C138.2, C139.2, C140.2, C141.2, C142.2, C143.2, R155.2, R156.2, U11.4 (VDD33_1), U11.10 (VDDCRREF/VDD33), U11.14 (VDD33), U11.20 (VDD33_2), U11.27 (VDDPLLREF/VDD33); also elsewhere on the board
XTALIN: C137.2, R160.2, U11.24 (XTALIN/CLKIN), Y5.3
XTALOUT: C144.2, R160.1, U11.23 (XTALOUT), Y5.1
