kylehagin/AM3358_Schematic/(notices)

Notices in the files:
parts and their libraries:
Wurth_Elektronik_Passive_rev15d: Copyright: Würth Elektronik
con-fci: Copyright (C) 2008, Bob Starr
